mm011106/509_circuit/parts/obsolate/ER150D_24ch_parts_Main.MBOM.txt

---	2	 C14 R62
1SS372	2	 D1 D2
AD8227ARZ	1	 U11
0.1u/16V	30	 C9 C10 C11 C15 C16 C18 C21 C22 C24 C25 C27 C28 C30 C32 C34 C36 C38 C39 C41 C42 C43 C44 C45 C47 C48 C49 C50 C51 C54 C55
7.5k	1	 R5
TLP291GR	1	 U30
20k/POT	1	 R12
74VHC9541FT	1	 U29
15k/0.05%/10ppm	1	 R57
TPS79918DDC	1	 U28
MAX4617CUE+	8	 U12 U14 U16 U18 U20 U22 U23 U25
10k/THICK	2	 R63 R66
2.2n	1	 C19
PCS-XE50LFD	1	 CN16
39k	1	 R50
DF11-14DP-2DSA	1	 CN20
30/THICK	1	 R46
20k/THICK	5	 R78 R79 R80 R81 R82
1SS226	1	 D3
NJU7108F3	1	 U7
91k	1	 R6
22n	3	 C1 C2 C6
68k	3	 R7 R42 R43
47k	1	 R4
VAB-3-10	1	 M1
PIN_HEADER_SOCKET_14PIN	1	 CN19
TPS3808G01DBV	1	 U6
0	5	 R22 R27 R28 R33 R35
51k	18	 R8 R9 R10 R11 R13 R14 R15 R16 R21 R30 R31 R32 R37 R38 R40 R41 R44 R45
4.7u/25V	2	 C13 C53
1k/THICK	7	 R65 R67 R68 R69 R70 R71 R83
56u/10V/OS	3	 C8 C23 C46
74VHC4052AFT	1	 U10
2k/THICK	1	 R84
11k	1	 R25
47/THICK	2	 R18 R39
ACM4520-142	5	 L1 L2 L3 L4 L5
TS5A23159DGS	2	 U3 U9
1M/THICK	1	 R34
3.3n	4	 C3 C4 C5 C7
82k	1	 R3
4.7n	1	 C17
DF11-4DP-2DSA	4	 CN1 CN2 CN3 CN4
RXEF050	1	 F1
10u/25V	1	 C57
100/0.05%/10ppm	1	 R56
OPA2344EA	4	 U1 U2 U5 U8
5M160ZT100	1	 U27
TP-1MMPAD	4	 TP11 TP12 TP13 TP14
100k	5	 R1 R47 R48 R51 R52
9.1k	2	 R17 R23
PH-2X5S	1	 CN18
620/THICK	1	 R58
TP-LC3G	10	 TP1 TP2 TP3 TP4 TP5 TP6 TP7 TP8 TP9 TP15
110k	1	 R24
1u/25V	7	 C20 C26 C58 C59 C60 C61 C62
2k/0.05%/10ppm	1	 R55
5.6k	1	 R49
100k/POT	1	 R2
TPS79933DDC	2	 U4 U26
100k/THICK	9	 R26 R36 R64 R72 R73 R74 R75 R76 R77
10k	5	 R19 R20 R29 R53 R54
10n	3	 C12 C52 C56
