mm011106/509_circuit/parts/obsolate/ER150D_24ch_parts_main_PBAN.xlsx

Sheet: 必ずお読みください
入力項目説明
メ ー カ ー |  |  | 電子部品のメーカー名をご入力ください。
部 品 種 別 |  |  | 電子部品の種別をご入力ください。例：チップ抵抗、トランジスタ、LED、など
電 子 部 品 型 番 |  |  | 電子部品の型番をご入力ください。 ※誤表記による不具合を回避するためにも正確なご入力をお願い致します。 ※表面実装の抵抗やコンデンサ(電解、タンタル以外)は、後述「電子部品見取り表」をご参照のうえ、ご入力ください。
配 置 記 号 / リファレンス |  |  | シルク図/配置図に表記された配置記号/リファレンス番号をご入力ください。 ※複数入力する場合は、カンマ「,」区切りでのご入力をお願い致します。 (入力例)R1～R5、R1-5と略さず、R1,R2,R3,R4,R5とご入力ください。 ※電子部品型番ベースでのご記入をお願い致します。（１つの電子部品型番に対して、配置番号を複数記入）
個 数 |  |  | 電子部品の個数をご入力ください。
ピ ン 数 |  |  | 電子部品の総ピン数をご入力ください。 ※基板取付穴、部品取付穴、全てのスルー・ノンスルーホール、面実装部品のパッド、及び次の①～⑤の配線を伴う箇所（①テストピン、②チェックランド、③引き出しランド、④ジャンパピン、⑤入出力ランドの総計。
実装 / 未実装 |  |  | 実装サービスでの「実装」/「未実装」をご選択ください。 ※同じ電子部品型番の中で実装と未実装が分かれる場合は、それぞれ2行に分けて配置記号をご入力ください。
部品分類 | SMD |  | 表面実装部品
 | DIP |  | 挿入部品
 | 特殊 BGA等 |  | BGA/CSP/LGA/QFNなど部品極性が部品の真下に配置された部品 -BGA：Ball Grid Array/下面に半田ボールの端子を配置したパッケージ。 -CSP：Chip Size Package/チッププサイズと同じか、もしくは僅かに大きいパッケージ。 -LGA：Land Grid Array/裏面に外部入出力用のランドを設けたパッケージ。※BGAの半田ボールがない。 -QFN：Quad Flat Non-Lead Package/QFPに似ていますが、外部入出力用のピンが出ていないパッケージ。
P板.com提供部品 (無料) |  |  | 【無償提供部品一覧】シートに記載されている「メーカー型番」を【部品リスト入力フォーム】シートのD列（電子部品型番）に入力し、I列（実装／未実装）を「実装」に設定いただくと、自動的に「○」が表示されます。 ※無料提供部品：チップコンデンサ/チップ抵抗を約1000種、実装サービスをご利用のお客様に無料提供いたします。 ※「○」が付かない場合は全半角の不一致などにより誤判定されている可能性があります。【無償提供部品一覧】シートより型番をコピー＆ペーストにて【部品リスト入力フォーム】にご入力ください。
 |  |  | http://www.p-ban.com/implementation/chip.html
P板.com調達部品(有料） |  |  | P板.com実装サービスで部品調達を希望される場合に○をご選択ください。 ※調達費用のお見積もりは、部品リストの返却と同時にご連絡いたします。 ※ご希望の納期や市場在庫状況によっては、調達が不可となる部品もございますので、予めご了承ください。
パッケージ情報 部品外形/部品仕様 |  |  | 電子部品のパッケージ情報をご入力ください。例：1608 , DIP , 0.5mmピッチQFP , 0.4mmピッチCN
コ メ ン ト |  |  | 特別なご指示のある電子部品について、自由にご入力ください。 例：未実装挿入穴のマスク処理が必要、など
版、変更履歴 |  |  | 部品種毎に、変更履歴を記載してください。 版は、アカウント登録の版に合わせて記載ください。
調達型式、代替型式 |  |  | 無料提供部品の在庫切れや、正確な調達型式を記載いたします。
部品名称見取り表
1.チップ部品（抵抗、コンデンサ）
 |  |  |  |  | 単位：ｍｍ
 |  |  | 電子部品型番 (C:コンデンサ、R:抵抗） | Ａ寸法 | Ｂ寸法
 |  |  | C/R1608 | 1.6 | 0.8
 |  |  | C/R2125 | 2 | 1.25
 |  |  | C/R3216 | 3.2 | 1.6
 |  |  | C/R3225 | 3.2 | 2.5
 |  |  | C/R4532 | 4.5 | 3.2
2.チップタンタルコンデンサ
 |  |  |  |  | 単位：ｍｍ
 |  |  | 電子部品型番 | Ａ寸法 | Ｂ寸法
 |  |  | CT3216 | 3.2 | 1.6
 |  |  | CT3528 | 3.5 | 2.8
 |  |  | CT4726 | 4.7 | 2.6
 |  |  | CT6032 | 6 | 3.2
 |  |  | CT5846 | 5.8 | 4.6
 |  |  | CT7343 | 7.3 | 4.3
3.チップアルミ電解コンデンサ
 |  |  |  |  |  | 単位：ｍｍ
 |  |  | 電子部品型番 | Ａ寸法 | Ｂ寸法 | C寸法
 |  |  | CE33 | 3.3 | 3.3 | φ3.0
 |  |  | CE43 | 4.3 | 4.3 | φ4.0
 |  |  | CE53 | 5.3 | 5.3 | φ5.0
 |  |  | CE66 | 6.6 | 6.6 | φ6.3
 |  |  | CE83 | 8.3 | 8.3 | φ8.0
 |  |  | CE103 | 10.3 | 10.3 | φ10.0
部品取り付け穴は、ピン数に含めてください。
コネクタの場合 |  |  |  |  |  | トランスの場合
部品リストフォーマット変更履歴
2014-02-01 | v2.0 | 松森 | 部品種別の総計を、直接関数に変更
 |  |  | ピン数合計、実装数合計数量を、直接関数に変更
 |  |  | 部品調達見積欄を修正
2014-03-11 | v2.1 | 松森 | *N列、O列が下の方、"○"選択リスト消えていたのを追加
 |  |  | *縮小しても解像度崩れず文字表示するため、フォントを"Meiryo UI"(Windows 標準添付)に変更
 |  |  | *136行目以降を非表示
 |  |  | *"X"列にリストを埋め込み
2014-06-12 | v2.2 | 松森 | *固定行を変更
 |  |  | *在庫状況列に条件付き書式設定
 |  |  | *その他各種バグ修正
2015-03-31 | V2.3 | 松森 | *無償提供部品を記載すると、無償提供部品欄に自動で"○"が表示されるよう条件式を挿入
 |  |  | *併せて、無償提供部品参照用一覧シートの作成・追加
 |  |  | *最小購入数が必要数量を下回る場合、セルを赤色にハッチングする
 |  |  | *シート1の名称変更
 |  |  | *変更履歴シートの追加
2015-06-19 | v2.4 | 松森 | ・ゼロΩ抵抗を無償対象に追加
 |  |  | ・変更履歴の列を追加し、変更履歴シートを削除
 |  |  | ・その他書式、印刷機能の変更
 |  |  | ・無償提供部品の入れ替え
2015-08-14 | v2.5 | 松森 | ・ゼロΩ抵抗の無償対象品が正しく反映されていなかったバグ修正
 |  |  | ・フォームへバージョン情報を埋め込み
2015-11-05 | v2.6 | 上田 | ・無償提供部品(RK73H2ATTD1601F)の抵抗値を正しい値に修正
2015-11-09 | v2.7 | 上田 | ・P板.com調達部品(無料)欄のフォントを変更
2016-01-15 | v2.8 | 箕浦 | ・無償提供部品一覧の「GRM32NF11E106Z」を削除
 |  |  | ・部品リスト入力フォームの4行目F列～L列の計算式が136行目以降を対象としていなかった不具合を修正
2016-01-27 | v2.9 | 箕浦 | ・「無償提供部品一覧」シートの表記修正
2016-08-26 | v2.10 | 松森 | ・「GRM31CF11E106Z」の許容差値修正
2016-11-15 | v2.11 | 松森 | ・部品調達欄表示順序変更
 |  |  | ・備考欄、荷姿欄追加
 |  |  | ・在庫状況のリスト微修正
2017-03-21 | v2.12 | 松森 | ・調達金額合計欄作成
 |  |  | ・在庫状況「長納期」を追加
 |  |  | ・その他微修正
2017-06-29 | v2.13 | 松森 | ・村田製3216サイズ以上のチップコンの取扱い中止
2017-07-19 | V2.14 | 松森 | ・KOA製1005サイズの定格電力を0.1Wに変更
 |  |  | (2015年10月のKOA仕様変更に伴う)
2017-09-14 | v2.15 | 松森 | ・KOA製2012サイズの定格電力を0.25Wへ変更
 |  |  | ・KOA製1608サイズ、1K以下の定格電力を0.125Wへ変更
 |  |  | ・MURATA製一部型式、許容差および定格修正
 |  |  | ・MURATA製一部部品削除
 |  |  | ・その他書式設定等微修正
2017-10-12 | v2.20 | 松森 | ・部品調達関連項目の移動
 |  |  | ・条件付き書式追加
2018-06-22 | v2.31 | 松森 | ・「1608」サイズと「2012」サイズのチップコンデンサを無償対象品から除外
2018-10-18 | V2.32 | 山田 | ・部品調達関連項目追加（条件付き書式追加/在庫状況：在庫少追加）
 |  |  | ・「必ずお読みください」シートの「配置記号 / リファレンス」の項目修正（配置記号の省略について）
2019-09-05 | V2.4 | 岡田 | Excelファイル名を部品表内に表記する関数追加
 |  |  | 無償提供部品型番入力後にスペースが入るとO列に丸がされない問題を修正
2019-09-10 | V2.41 | 岡田 | "AD"列にトレイ追加

Sheet: 部品リスト入力フォーム
partslist(Rev,2.41) |  |  | 電 子 部 品 型 番 ※半角英数字 ※サフィックスまで入力必須 | 配 置 記 号 リ フ ァ レ ン ス ※半角英数字） | 個数 | ピ ン 数 (部品取付穴 を含む） |  | 実装/ 未実装 | 部 品 分 類 |  |  | 必要数 実装枚数を入れてください。 ↓ | P板.com 提供 部品 (無料) | P板.com 調達 部品 (有料） | パッケージ情報 部品外形/部品仕様 | コ メ ン ト ※未実装挿入穴のマスク 処理が必要、など | 版 変更履歴 | 入荷数 | 返却
ER150D_24ch_parts_main_PBAN.xlsx
No | メーカー | 部品種別 |  |  |  | 1個 あたり | 合計 | 実装個数 | SMD | DIP | 特殊 BGA等 |  |  |  |  |  |  |  |  | P板.com部品調達使用欄
 |  |  |  |  | 187 | 389 | 774 | 186 | 162 | 24 | 0 | 2 | リスト (http://www.p-ban.com/implementation/chip.html)
例 | KOA | チップ抵抗 | RK73B2ATTD1002F | R1,R5,R9,R10 | 4 | 2 | 8 | 未実装 | SMD |  |  |  |  |  | 2012 |  | 4版 型式訂正、個数変更、 実装→未実装へ |  |  | 必要数 | 調達数 | 在庫状況 | メーカ | 調達品番 | 荷姿 | 納期 | 備考
1 □ | AD | 差動アンプ | AD8227ARZ | U11 | 1 | 8 | 8 | 実装 | SMD |  |  | 2 |  |  |  |  |  |  | □
2 □ | AKIZUKI | 2列ピンソケット | C-00169 | CN19 | 1 | 14 | 14 | 実装 | DIP |  |  | 2 |  |  |  |  |  |  | □
3 □ | AKIZUKI | 2列ピンヘッダ | PH-2x5SG | CN18 | 1 | 10 | 10 | 実装 | DIP |  |  | 2 |  |  |  |  |  |  | □
4 □ | ALTERA | CPLD | 5M160ZT100C5N | U27 | 1 | 100 | 100 | 実装 | SMD |  |  | 2 |  |  |  |  |  |  | □
5 □ | COPAL | 単回転ポテンショ | CT-6EP100kohm | R2 | 1 | 3 | 3 | 実装 | DIP |  |  | 2 |  |  |  |  |  |  | □
6 □ | COPAL | 単回転ポテンショ | CT-6EP20kohm | R12 | 1 | 3 | 3 | 実装 | DIP |  |  | 2 |  |  |  |  |  |  | □
7 □ | HIROSE | DF11コネクタ(PLUG) | DF11-14DP-2DSA(24) | CN20 | 1 | 14 | 14 | 実装 | DIP |  |  | 2 |  |  |  |  |  |  | □
8 □ | HIROSE | DF11コネクタ(PLUG) | DF11-4DP-2DSA(24) | CN1,CN2,CN3,CN4 | 4 | 4 | 16 | 実装 | DIP |  |  | 8 |  |  |  |  |  |  | □
9 □ | HIROSUGI | 取り付けスペーサ | VAB-3-10 | M1 | 1 | 1 | 1 | 未実装 | DIP |  |  | 0 |  |  |  |  |  |  | □
10 □ | HONDA | ハーフピッチSCSIコネクタ | PCS-XE50LFD+ | CN16 | 1 | 52 | 52 | 実装 | DIP |  |  | 2 |  |  |  |  |  |  | □
11 □ | JRC | コンパレータ | NJU7108F3 | U7 | 1 | 5 | 5 | 実装 | SMD |  |  | 2 |  |  |  |  |  |  | □
12 □ | KOA | 厚膜チップ抵抗 | RK73H1JTTD1001F | R65,R67,R68,R69,R70,R71,R83 | 7 | 2 | 14 | 実装 | SMD |  |  | 14 | ○ |  |  |  |  |  | □
13 □ | KOA | 厚膜チップ抵抗 | RK73H1JTTD1002F | R63,R66 | 2 | 2 | 4 | 実装 | SMD |  |  | 4 | ○ |  |  |  |  |  | □
14 □ | KOA | 厚膜チップ抵抗 | RK73H1JTTD1003F | R26,R36,R64,R72,R73,R74,R75,R76,R77 | 9 | 2 | 18 | 実装 | SMD |  |  | 18 | ○ |  |  |  |  |  | □
15 □ | KOA | 厚膜チップ抵抗 | RK73H1JTTD1004F | R34 | 1 | 2 | 2 | 実装 | SMD |  |  | 2 | ○ |  |  |  |  |  | □
16 □ | KOA | 厚膜チップ抵抗 | RK73H1JTTD2001F | R84 | 1 | 2 | 2 | 実装 | SMD |  |  | 2 | ○ |  |  |  |  |  | □
17 □ | KOA | 厚膜チップ抵抗 | RK73H1JTTD2002F | R78,R79,R80,R81,R82 | 5 | 2 | 10 | 実装 | SMD |  |  | 10 | ○ |  |  |  |  |  | □
18 □ | KOA | 厚膜チップ抵抗 | RK73H1JTTD30R0F | R46 | 1 | 2 | 2 | 実装 | SMD |  |  | 2 | ○ |  |  |  |  |  | □
19 □ | KOA | 厚膜チップ抵抗 | RK73H1JTTD47R0F | R18,R39 | 2 | 2 | 4 | 実装 | SMD |  |  | 4 | ○ |  |  |  |  |  | □
20 □ | KOA | 厚膜チップ抵抗 | RK73H1JTTD6200F | R58 | 1 | 2 | 2 | 実装 | SMD |  |  | 2 | ○ |  |  |  |  |  | □
21 □ | KOA | 厚膜チップ抵抗 | RK73Z1JTTD | R22,R27,R28,R33,R35 | 5 | 2 | 10 | 実装 | SMD |  |  | 10 | ○ |  |  |  |  |  | □
22 □ | MAC8 | テストポイント | LC-33-G | TP1,TP2,TP3,TP4,TP5,TP6,TP7,TP8,TP9,TP15 | 10 | 1 | 10 | 実装 | DIP |  |  | 20 |  |  |  |  |  |  | □
23 □ | MAXIM | アナログMPX | MAX4617CUE+ | U12,U14,U16,U18,U20,U22,U23,U25 | 8 | 16 | 128 | 実装 | SMD |  |  | 16 |  |  |  |  |  |  | □
24 □ | Panasonic | アルミ固体コンデンサ | 10SEP56M | C8,C23,C46 | 3 | 2 | 6 | 実装 | DIP |  |  | 6 |  |  |  |  |  |  | □
25 □ | SSM | 薄膜チップ抵抗 | RG1608N-101-W | R56 | 1 | 2 | 2 | 実装 | SMD |  |  | 2 |  |  |  |  |  |  | □
26 □ | SSM | 薄膜チップ抵抗 | RG1608N-153-W | R57 | 1 | 2 | 2 | 実装 | SMD |  |  | 2 |  |  |  |  |  |  | □
27 □ | SSM | 薄膜チップ抵抗 | RG1608N-202-W | R55 | 1 | 2 | 2 | 実装 | SMD |  |  | 2 |  |  |  |  |  |  | □
28 □ | SSM | 薄膜チップ抵抗 | RR0816P-103-D | R19,R20,R29,R53,R54 | 5 | 2 | 10 | 実装 | SMD |  |  | 10 |  |  |  |  |  |  | □
29 □ | SSM | 薄膜チップ抵抗 | RR0816P-104-D | R1,R47,R48,R51,R52 | 5 | 2 | 10 | 実装 | SMD |  |  | 10 |  |  |  |  |  |  | □
30 □ | SSM | 薄膜チップ抵抗 | RR0816P-113-D | R25 | 1 | 2 | 2 | 実装 | SMD |  |  | 2 |  |  |  |  |  |  | □
31 □ | SSM | 薄膜チップ抵抗 | RR0816P-114-D | R24 | 1 | 2 | 2 | 実装 | SMD |  |  | 2 |  |  |  |  |  |  | □
32 □ | SSM | 薄膜チップ抵抗 | RR0816P-393-D | R50 | 1 | 2 | 2 | 実装 | SMD |  |  | 2 |  |  |  |  |  |  | □
33 □ | SSM | 薄膜チップ抵抗 | RR0816P-473-D | R4 | 1 | 2 | 2 | 実装 | SMD |  |  | 2 |  |  |  |  |  |  | □
34 □ | SSM | 薄膜チップ抵抗 | RR0816P-513-D | R8,R9,R10,R11,R13,R14,R15,R16,R21,R30,R31,R32,R37,R38,R40,R41,R44,R45 | 18 | 2 | 36 | 実装 | SMD |  |  | 36 |  |  |  |  |  |  | □
35 □ | SSM | 薄膜チップ抵抗 | RR0816P-562-D | R49 | 1 | 2 | 2 | 実装 | SMD |  |  | 2 |  |  |  |  |  |  | □
36 □ | SSM | 薄膜チップ抵抗 | RR0816P-683-D | R7,R42,R43 | 3 | 2 | 6 | 実装 | SMD |  |  | 6 |  |  |  |  |  |  | □
37 □ | SSM | 薄膜チップ抵抗 | RR0816P-752-D | R5 | 1 | 2 | 2 | 実装 | SMD |  |  | 2 |  |  |  |  |  |  | □
38 □ | SSM | 薄膜チップ抵抗 | RR0816P-823-D | R3 | 1 | 2 | 2 | 実装 | SMD |  |  | 2 |  |  |  |  |  |  | □
39 □ | SSM | 薄膜チップ抵抗 | RR0816P-912-D | R17,R23 | 2 | 2 | 4 | 実装 | SMD |  |  | 4 |  |  |  |  |  |  | □
40 □ | SSM | 薄膜チップ抵抗 | RR0816P-913-D | R6 | 1 | 2 | 2 | 実装 | SMD |  |  | 2 |  |  |  |  |  |  | □
41 □ | TDK | コモンモードチョーク | ACM4520-142-2P | L1,L2,L3,L4,L5 | 5 | 4 | 20 | 実装 | SMD |  |  | 10 |  |  |  |  |  |  | □
42 □ | TDK | 積層セラミックコンデンサ | C1608X5R1E475K | C13,C53 | 2 | 2 | 4 | 実装 | SMD |  |  | 4 |  |  |  |  |  |  | □
43 □ | TDK | 積層セラミックコンデンサ | CGA3E3X5R1E105K | C20,C26,C58,C59,C60,C61,C62 | 7 | 2 | 14 | 実装 | SMD |  |  | 14 |  |  |  |  |  |  | □
44 □ | TE | ポリスイッチ | RXEF050 | F1 | 1 | 2 | 2 | 実装 | DIP |  |  | 2 |  |  |  |  |  |  | □
45 □ | TI | アナログスイッチ | TS5A23159DGS | U3,U9 | 2 | 10 | 20 | 実装 | SMD |  |  | 4 |  |  |  |  |  |  | □
46 □ | TI | オペアンプ | OPA2344EA | U1,U2,U5,U8 | 4 | 8 | 32 | 実装 | SMD |  |  | 8 |  |  |  |  |  |  | □
47 □ | TI | 電圧レギュレータ | TPS79918DDC | U28 | 1 | 5 | 5 | 実装 | SMD |  |  | 2 |  |  |  |  |  |  | □
48 □ | TI | 電圧レギュレータ | TPS79933DDC | U4,U26 | 2 | 5 | 10 | 実装 | SMD |  |  | 4 |  |  |  |  |  |  | □
49 □ | TI | 電圧監視 | TPS3808G01DBV | U6 | 1 | 6 | 6 | 実装 | SMD |  |  | 2 |  |  |  |  |  |  | □
50 □ | TOSHIBA | C-MOS | 74VHC9541FT | U29 | 1 | 20 | 20 | 実装 | SMD |  |  | 2 |  |  |  |  |  |  | □
51 □ | TOSHIBA | C-MOS | TC74VHC4052AFT | U10 | 1 | 16 | 16 | 実装 | SMD |  |  | 2 |  |  |  |  |  |  | □
52 □ | TOSHIBA | ショットキーダイオード | 1SS226 | D3 | 1 | 3 | 3 | 実装 | SMD |  |  | 2 |  |  |  |  |  |  | □
53 □ | TOSHIBA | ショットキーダイオード | 1SS372 | D1,D2 | 2 | 3 | 6 | 実装 | SMD |  |  | 4 |  |  |  |  |  |  | □
54 □ | TOSHIBA | フォトカプラ | TLP291(GR,SE | U30 | 1 | 4 | 4 | 実装 | SMD |  |  | 2 |  |  |  |  |  |  | □
55 □ | 村田製作所 | 積層セラミックコンデンサ | GRM155B31C104K | C9,C10,C11,C15,C16,C18,C21,C22,C24,C25,C27,C28,C30,C32,C34,C36,C38,C39,C41,C42,C43,C44,C45,C47,C48,C49,C50,C51,C54,C55 | 30 | 2 | 60 | 実装 | SMD |  |  | 60 | ○ |  |  |  |  |  | □
56 □ | 村田製作所 | 積層セラミックコンデンサ | GRM2195C1H103J | C12,C52,C56 | 3 | 2 | 6 | 実装 | SMD |  |  | 6 |  |  |  |  |  |  | □
57 □ | 村田製作所 | 積層セラミックコンデンサ | GRM1882C1H222J | C19 | 1 | 2 | 2 | 実装 | SMD |  |  | 2 |  |  |  |  |  |  | □
58 □ | 村田製作所 | 積層セラミックコンデンサ | GRM1882C1H332J | C3,C4,C5,C7 | 4 | 2 | 8 | 実装 | SMD |  |  | 8 |  |  |  |  |  |  | □
59 □ | 村田製作所 | 積層セラミックコンデンサ | GRM2162C1H472J | C17 | 1 | 2 | 2 | 実装 | SMD |  |  | 2 |  |  |  |  |  |  | □
60 □ | 村田製作所 | 積層セラミックコンデンサ | GRM21B2C1H223J | C1,C2,C6 | 3 | 2 | 6 | 実装 | SMD |  |  | 6 |  |  |  |  |  |  | □
61 □ | 村田製作所 | 積層セラミックコンデンサ | GRM31CR61E106K | C57 | 1 | 2 | 2 | 実装 | SMD |  |  | 2 |  |  |  |  |  |  | □
62 □ |  |  |  |  |  |  |  |  |  |  |  |  |  |  |  |  |  |  | □
63 □ |  |  |  |  |  |  |  |  |  |  |  |  |  |  |  |  |  |  | □
64 □ |  |  |  |  |  |  |  |  |  |  |  |  |  |  |  |  |  |  | □
65 □ |  |  |  |  |  |  |  |  |  |  |  |  |  |  |  |  |  |  | □
66 □ |  |  |  |  |  |  |  |  |  |  |  |  |  |  |  |  |  |  | □
67 □ |  |  |  |  |  |  |  |  |  |  |  |  |  |  |  |  |  |  | □
68 □ |  |  |  |  |  |  |  |  |  |  |  |  |  |  |  |  |  |  | □
69 □ |  |  |  |  |  |  |  |  |  |  |  |  |  |  |  |  |  |  | □
70 □ |  |  |  |  |  |  |  |  |  |  |  |  |  |  |  |  |  |  | □
71 □ |  |  |  |  |  |  |  |  |  |  |  |  |  |  |  |  |  |  | □
72 □ |  |  |  |  |  |  |  |  |  |  |  |  |  |  |  |  |  |  | □
73 □ |  |  |  |  |  |  |  |  |  |  |  |  |  |  |  |  |  |  | □
74 □ |  |  |  |  |  |  |  |  |  |  |  |  |  |  |  |  |  |  | □
75 □ |  |  |  |  |  |  |  |  |  |  |  |  |  |  |  |  |  |  | □
76 □ |  |  |  |  |  |  |  |  |  |  |  |  |  |  |  |  |  |  | □
77 □ |  |  |  |  |  |  |  |  |  |  |  |  |  |  |  |  |  |  | □
78 □ |  |  |  |  |  |  |  |  |  |  |  |  |  |  |  |  |  |  | □
79 □ |  |  |  |  |  |  |  |  |  |  |  |  |  |  |  |  |  |  | □
80 □ |  |  |  |  |  |  |  |  |  |  |  |  |  |  |  |  |  |  | □
81 □ |  |  |  |  |  |  |  |  |  |  |  |  |  |  |  |  |  |  | □
82 □ |  |  |  |  |  |  |  |  |  |  |  |  |  |  |  |  |  |  | □
83 □ |  |  |  |  |  |  |  |  |  |  |  |  |  |  |  |  |  |  | □
84 □ |  |  |  |  |  |  |  |  |  |  |  |  |  |  |  |  |  |  | □
85 □ |  |  |  |  |  |  |  |  |  |  |  |  |  |  |  |  |  |  | □
86 □ |  |  |  |  |  |  |  |  |  |  |  |  |  |  |  |  |  |  | □
87 □ |  |  |  |  |  |  |  |  |  |  |  |  |  |  |  |  |  |  | □
88 □ |  |  |  |  |  |  |  |  |  |  |  |  |  |  |  |  |  |  | □
89 □ |  |  |  |  |  |  |  |  |  |  |  |  |  |  |  |  |  |  | □
90 □ |  |  |  |  |  |  |  |  |  |  |  |  |  |  |  |  |  |  | □
91 □ |  |  |  |  |  |  |  |  |  |  |  |  |  |  |  |  |  |  | □
92 □ |  |  |  |  |  |  |  |  |  |  |  |  |  |  |  |  |  |  | □
93 □ |  |  |  |  |  |  |  |  |  |  |  |  |  |  |  |  |  |  | □
94 □ |  |  |  |  |  |  |  |  |  |  |  |  |  |  |  |  |  |  | □
95 □ |  |  |  |  |  |  |  |  |  |  |  |  |  |  |  |  |  |  | □
96 □ |  |  |  |  |  |  |  |  |  |  |  |  |  |  |  |  |  |  | □
97 □ |  |  |  |  |  |  |  |  |  |  |  |  |  |  |  |  |  |  | □
98 □ |  |  |  |  |  |  |  |  |  |  |  |  |  |  |  |  |  |  | □
99 □ |  |  |  |  |  |  |  |  |  |  |  |  |  |  |  |  |  |  | □
100 □ |  |  |  |  |  |  |  |  |  |  |  |  |  |  |  |  |  |  | □
101 □ |  |  |  |  |  |  |  |  |  |  |  |  |  |  |  |  |  |  | □
102 □ |  |  |  |  |  |  |  |  |  |  |  |  |  |  |  |  |  |  | □
103 □ |  |  |  |  |  |  |  |  |  |  |  |  |  |  |  |  |  |  | □
104 □ |  |  |  |  |  |  |  |  |  |  |  |  |  |  |  |  |  |  | □
105 □ |  |  |  |  |  |  |  |  |  |  |  |  |  |  |  |  |  |  | □
106 □ |  |  |  |  |  |  |  |  |  |  |  |  |  |  |  |  |  |  | □
107 □ |  |  |  |  |  |  |  |  |  |  |  |  |  |  |  |  |  |  | □
108 □ |  |  |  |  |  |  |  |  |  |  |  |  |  |  |  |  |  |  | □
109 □ |  |  |  |  |  |  |  |  |  |  |  |  |  |  |  |  |  |  | □
110 □ |  |  |  |  |  |  |  |  |  |  |  |  |  |  |  |  |  |  | □
111 □ |  |  |  |  |  |  |  |  |  |  |  |  |  |  |  |  |  |  | □
112 □ |  |  |  |  |  |  |  |  |  |  |  |  |  |  |  |  |  |  | □
113 □ |  |  |  |  |  |  |  |  |  |  |  |  |  |  |  |  |  |  | □
114 □ |  |  |  |  |  |  |  |  |  |  |  |  |  |  |  |  |  |  | □
115 □ |  |  |  |  |  |  |  |  |  |  |  |  |  |  |  |  |  |  | □
116 □ |  |  |  |  |  |  |  |  |  |  |  |  |  |  |  |  |  |  | □
117 □ |  |  |  |  |  |  |  |  |  |  |  |  |  |  |  |  |  |  | □
118 □ |  |  |  |  |  |  |  |  |  |  |  |  |  |  |  |  |  |  | □
119 □ |  |  |  |  |  |  |  |  |  |  |  |  |  |  |  |  |  |  | □
120 □ |  |  |  |  |  |  |  |  |  |  |  |  |  |  |  |  |  |  | □
121 □ |  |  |  |  |  |  |  |  |  |  |  |  |  |  |  |  |  |  | □
122 □ |  |  |  |  |  |  |  |  |  |  |  |  |  |  |  |  |  |  | □
123 □ |  |  |  |  |  |  |  |  |  |  |  |  |  |  |  |  |  |  | □
124 □ |  |  |  |  |  |  |  |  |  |  |  |  |  |  |  |  |  |  | □
125 □ |  |  |  |  |  |  |  |  |  |  |  |  |  |  |  |  |  |  | □
126 □ |  |  |  |  |  |  |  |  |  |  |  |  |  |  |  |  |  |  | □
127 □ |  |  |  |  |  |  |  |  |  |  |  |  |  |  |  |  |  |  | □
128 □ |  |  |  |  |  |  |  |  |  |  |  |  |  |  |  |  |  |  | □
129 □ |  |  |  |  |  |  |  |  |  |  |  |  |  |  |  |  |  |  | □
130 □ |  |  |  |  |  |  |  |  |  |  |  |  |  |  |  |  |  |  | □
131 □ |  |  |  |  |  |  |  |  |  |  |  |  |  |  |  |  |  |  | □
132 □ |  |  |  |  |  |  |  |  |  |  |  |  |  |  |  |  |  |  | □
133 □ |  |  |  |  |  |  |  |  |  |  |  |  |  |  |  |  |  |  | □
134 □ |  |  |  |  |  |  |  |  |  |  |  |  |  |  |  |  |  |  | □
135 □ |  |  |  |  |  |  |  |  |  |  |  |  |  |  |  |  |  |  | □
136 □ |  |  |  |  |  |  |  |  |  |  |  |  |  |  |  |  |  |  | □
137 □ |  |  |  |  |  |  |  |  |  |  |  |  |  |  |  |  |  |  | □
138 □ |  |  |  |  |  |  |  |  |  |  |  |  |  |  |  |  |  |  | □
139 □ |  |  |  |  |  |  |  |  |  |  |  |  |  |  |  |  |  |  | □
140 □ |  |  |  |  |  |  |  |  |  |  |  |  |  |  |  |  |  |  | □
141 □ |  |  |  |  |  |  |  |  |  |  |  |  |  |  |  |  |  |  | □
142 □ |  |  |  |  |  |  |  |  |  |  |  |  |  |  |  |  |  |  | □
143 □ |  |  |  |  |  |  |  |  |  |  |  |  |  |  |  |  |  |  | □
144 □ |  |  |  |  |  |  |  |  |  |  |  |  |  |  |  |  |  |  | □
145 □ |  |  |  |  |  |  |  |  |  |  |  |  |  |  |  |  |  |  | □
146 □ |  |  |  |  |  |  |  |  |  |  |  |  |  |  |  |  |  |  | □
147 □ |  |  |  |  |  |  |  |  |  |  |  |  |  |  |  |  |  |  | □
148 □ |  |  |  |  |  |  |  |  |  |  |  |  |  |  |  |  |  |  | □

Sheet: 無償提供部品一覧
このシートの内容は変更しないでください。
メーカー型番 |  | メーカー | サイズ | 定数 | 許容差 | 定格
RK73Z1ETTP | ○ | KOA | 1005 | 0 | － | 1A
RK73H1ETTP1R00F | ○ | KOA | 1005 | 1 | ±1% | 0.1W
RK73B1ETTP1R0J | ○ | KOA | 1005 | 1 | ±5% | 0.1W
RK73H1ETTP1R10F | ○ | KOA | 1005 | 1.1 | ±1% | 0.1W
RK73B1ETTP1R1J | ○ | KOA | 1005 | 1.1 | ±5% | 0.1W
RK73H1ETTP1R20F | ○ | KOA | 1005 | 1.2 | ±1% | 0.1W
RK73B1ETTP1R2J | ○ | KOA | 1005 | 1.2 | ±5% | 0.1W
RK73H1ETTP1R30F | ○ | KOA | 1005 | 1.3 | ±1% | 0.1W
RK73B1ETTP1R3J | ○ | KOA | 1005 | 1.3 | ±5% | 0.1W
RK73H1ETTP1R50F | ○ | KOA | 1005 | 1.5 | ±1% | 0.1W
RK73B1ETTP1R5J | ○ | KOA | 1005 | 1.5 | ±5% | 0.1W
RK73H1ETTP1R60F | ○ | KOA | 1005 | 1.6 | ±1% | 0.1W
RK73B1ETTP1R6J | ○ | KOA | 1005 | 1.6 | ±5% | 0.1W
RK73H1ETTP1R80F | ○ | KOA | 1005 | 1.8 | ±1% | 0.1W
RK73B1ETTP1R8J | ○ | KOA | 1005 | 1.8 | ±5% | 0.1W
RK73H1ETTP2R00F | ○ | KOA | 1005 | 2 | ±1% | 0.1W
RK73B1ETTP2R0J | ○ | KOA | 1005 | 2 | ±5% | 0.1W
RK73H1ETTP2R20F | ○ | KOA | 1005 | 2.2 | ±1% | 0.1W
RK73B1ETTP2R2J | ○ | KOA | 1005 | 2.2 | ±5% | 0.1W
RK73H1ETTP2R40F | ○ | KOA | 1005 | 2.4 | ±1% | 0.1W
RK73B1ETTP2R4J | ○ | KOA | 1005 | 2.4 | ±5% | 0.1W
RK73H1ETTP2R70F | ○ | KOA | 1005 | 2.7 | ±1% | 0.1W
RK73B1ETTP2R7J | ○ | KOA | 1005 | 2.7 | ±5% | 0.1W
RK73H1ETTP3R00F | ○ | KOA | 1005 | 3 | ±1% | 0.1W
RK73B1ETTP3R0J | ○ | KOA | 1005 | 3 | ±5% | 0.1W
RK73H1ETTP3R30F | ○ | KOA | 1005 | 3.3 | ±1% | 0.1W
RK73B1ETTP3R3J | ○ | KOA | 1005 | 3.3 | ±5% | 0.1W
RK73H1ETTP3R60F | ○ | KOA | 1005 | 3.6 | ±1% | 0.1W
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
GRM155B11H272K | ○ | MURATA | 1005 | 2700pF | ±10% | DC50V
GRM155B11H332K | ○ | MURATA | 1005 | 3300pF | ±10% | DC50V
GRM155B11H392K | ○ | MURATA | 1005 | 3900pF | ±10% | DC50V
GRM155B11H472K | ○ | MURATA | 1005 | 4700pF | ±10% | DC50V
GRM155B11E682K | ○ | MURATA | 1005 | 6800pF | ±10% | DC25V
GRM155B11E822K | ○ | MURATA | 1005 | 8200pF | ±10% | DC25V
GRM155B11E103K | ○ | MURATA | 1005 | 0.01uF | ±10% | DC25V
GRM155B31H103K | ○ | MURATA | 1005 | 0.01uF | ±10% | DC50V
GRM155B11C153K | ○ | MURATA | 1005 | 0.015uF | ±10% | DC16V
GRM155B31H153K | ○ | MURATA | 1005 | 0.015uF | ±10% | DC50V
GRM155B11C183K | ○ | MURATA | 1005 | 0.018uF | ±10% | DC16V
GRM155B11E223K | ○ | MURATA | 1005 | 0.022uF | ±10% | DC25V
GRM155B11C223K | ○ | MURATA | 1005 | 0.022uF | ±10% | DC16V
GRM155B11A333K | ○ | MURATA | 1005 | 0.033uF | ±10% | DC10V
GRM155B31E333K | ○ | MURATA | 1005 | 0.033uF | ±10% | DC25V
GRM155B11A473K | ○ | MURATA | 1005 | 0.047uF | ±10% | DC10V
GRM155B11C473K | ○ | MURATA | 1005 | 0.047uF | ±10% | DC16V
GRM155B11A563K | ○ | MURATA | 1005 | 0.056uF | ±10% | DC10V
GRM155B11A683K | ○ | MURATA | 1005 | 0.068uF | ±10% | DC10V
GRM155B11A823K | ○ | MURATA | 1005 | 0.082uF | ±10% | DC10V
GRM155B11A104K | ○ | MURATA | 1005 | 0.1uF | ±10% | DC10V
GRM155B31C104K | ○ | MURATA | 1005 | 0.1uF | ±10% | DC16V
GRM155B31A474K | ○ | MURATA | 1005 | 0.47uF | ±10% | DC10V
GRM155B30J105K | ○ | MURATA | 1005 | 1uF | ±10% | DC6.3V
