mm011106/509_circuit/509_CoilDriver_24ch_CKT.pdf

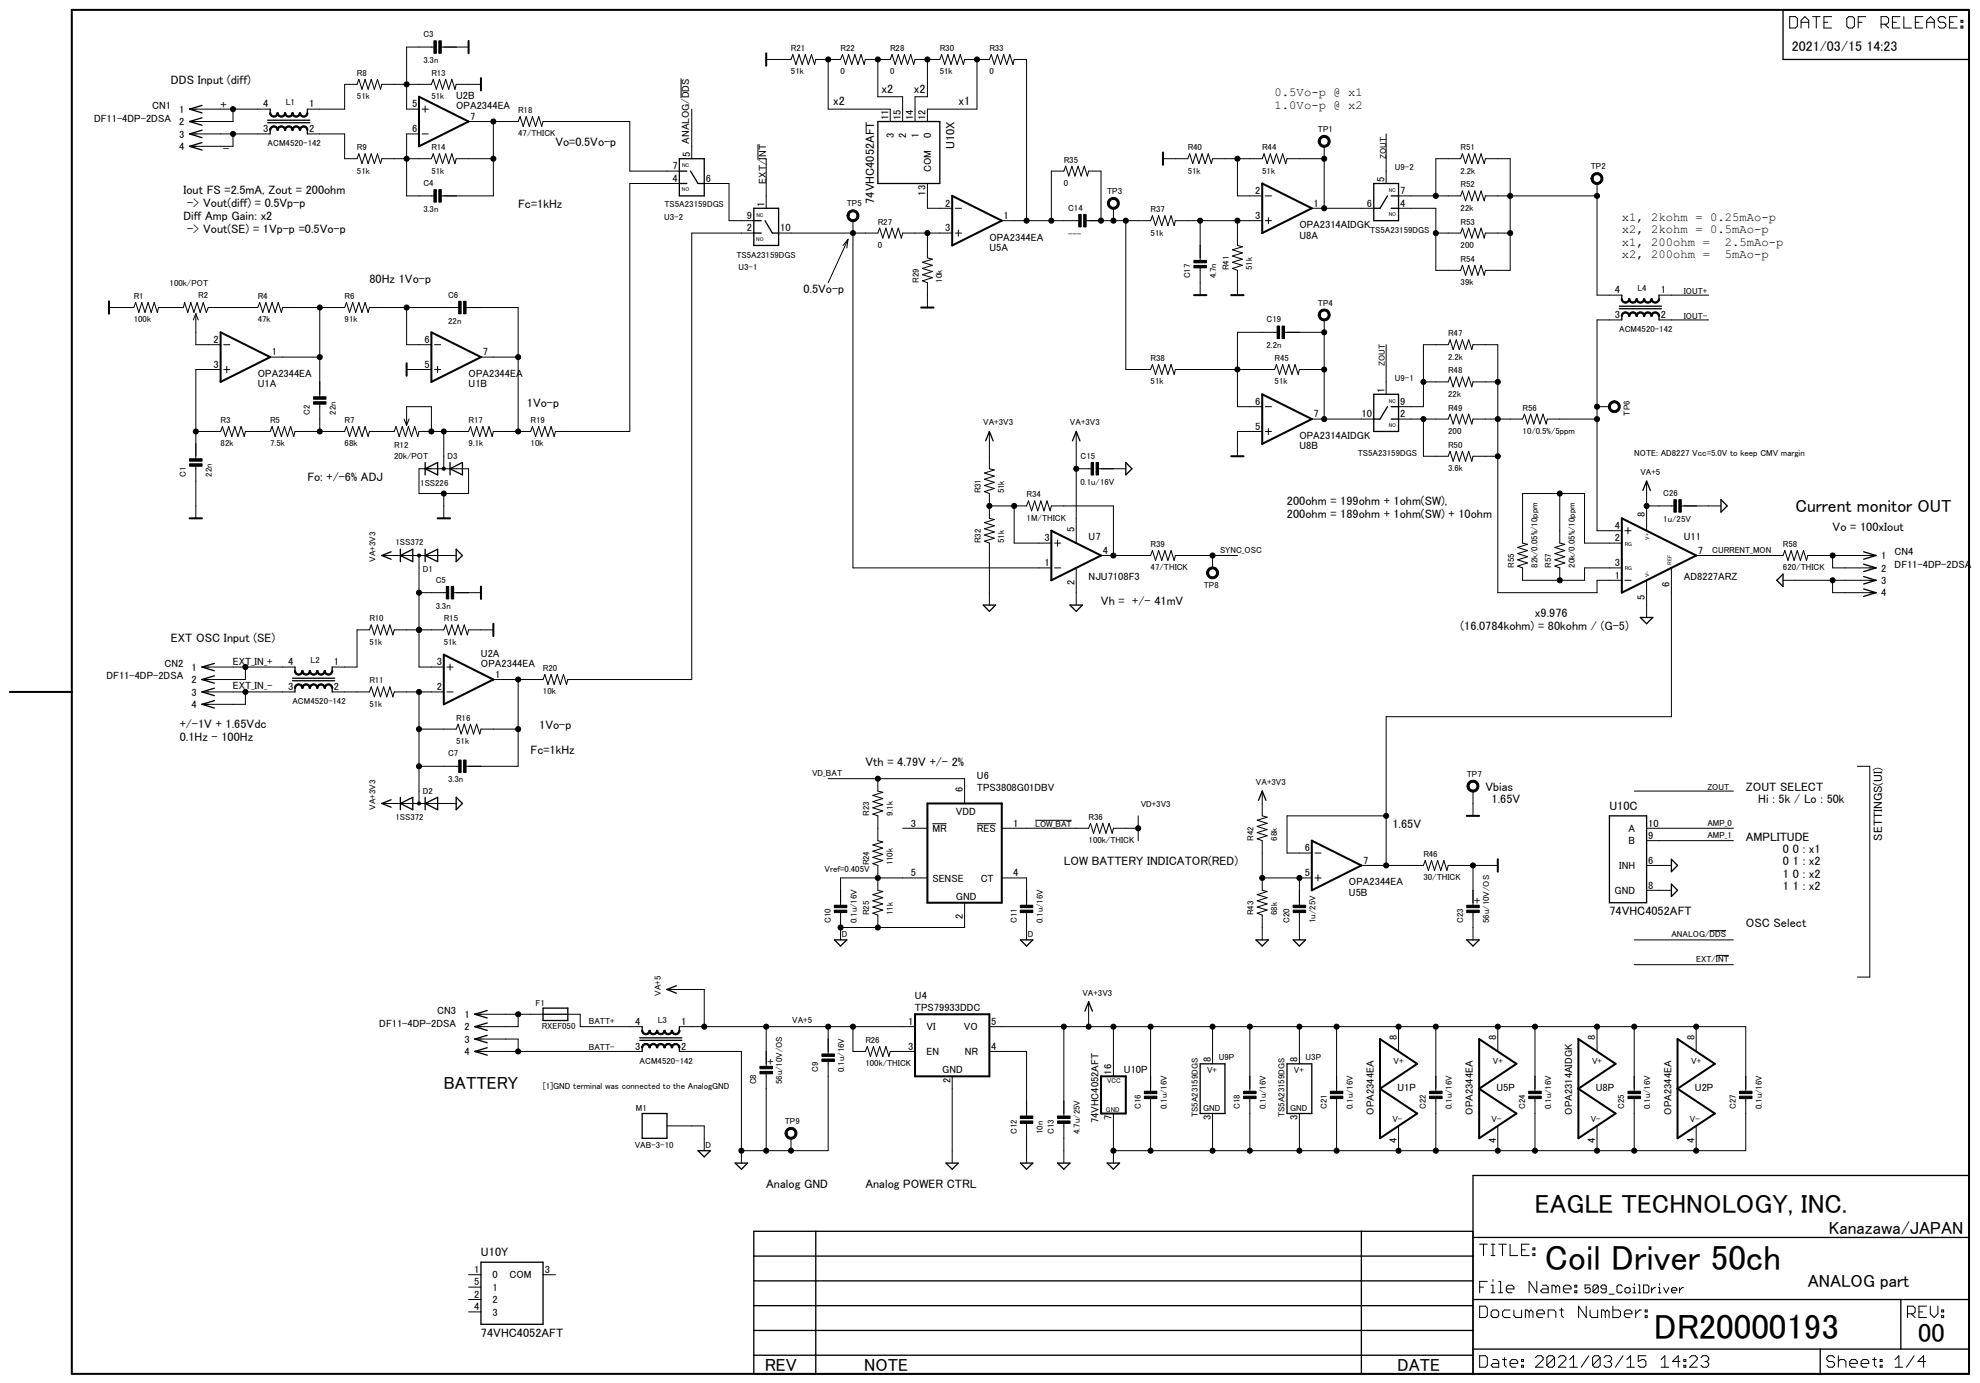
[picture p1: page 1]

Iout FS =2.5mA, Zout = 200ohm
-> Vout(diff) = 0.5Vp-p Diff Amp Gain: x2

NOTE: AD8227 Vcc=5.0V to keep CMV margin

EXT OSC Input (SE)

100k/THICK
LOW BATTERY INDICATOR(RED)

EAGLE TECHNOLOGY, INC. Kanazawa/JAPAN
Coil Driver 50ch

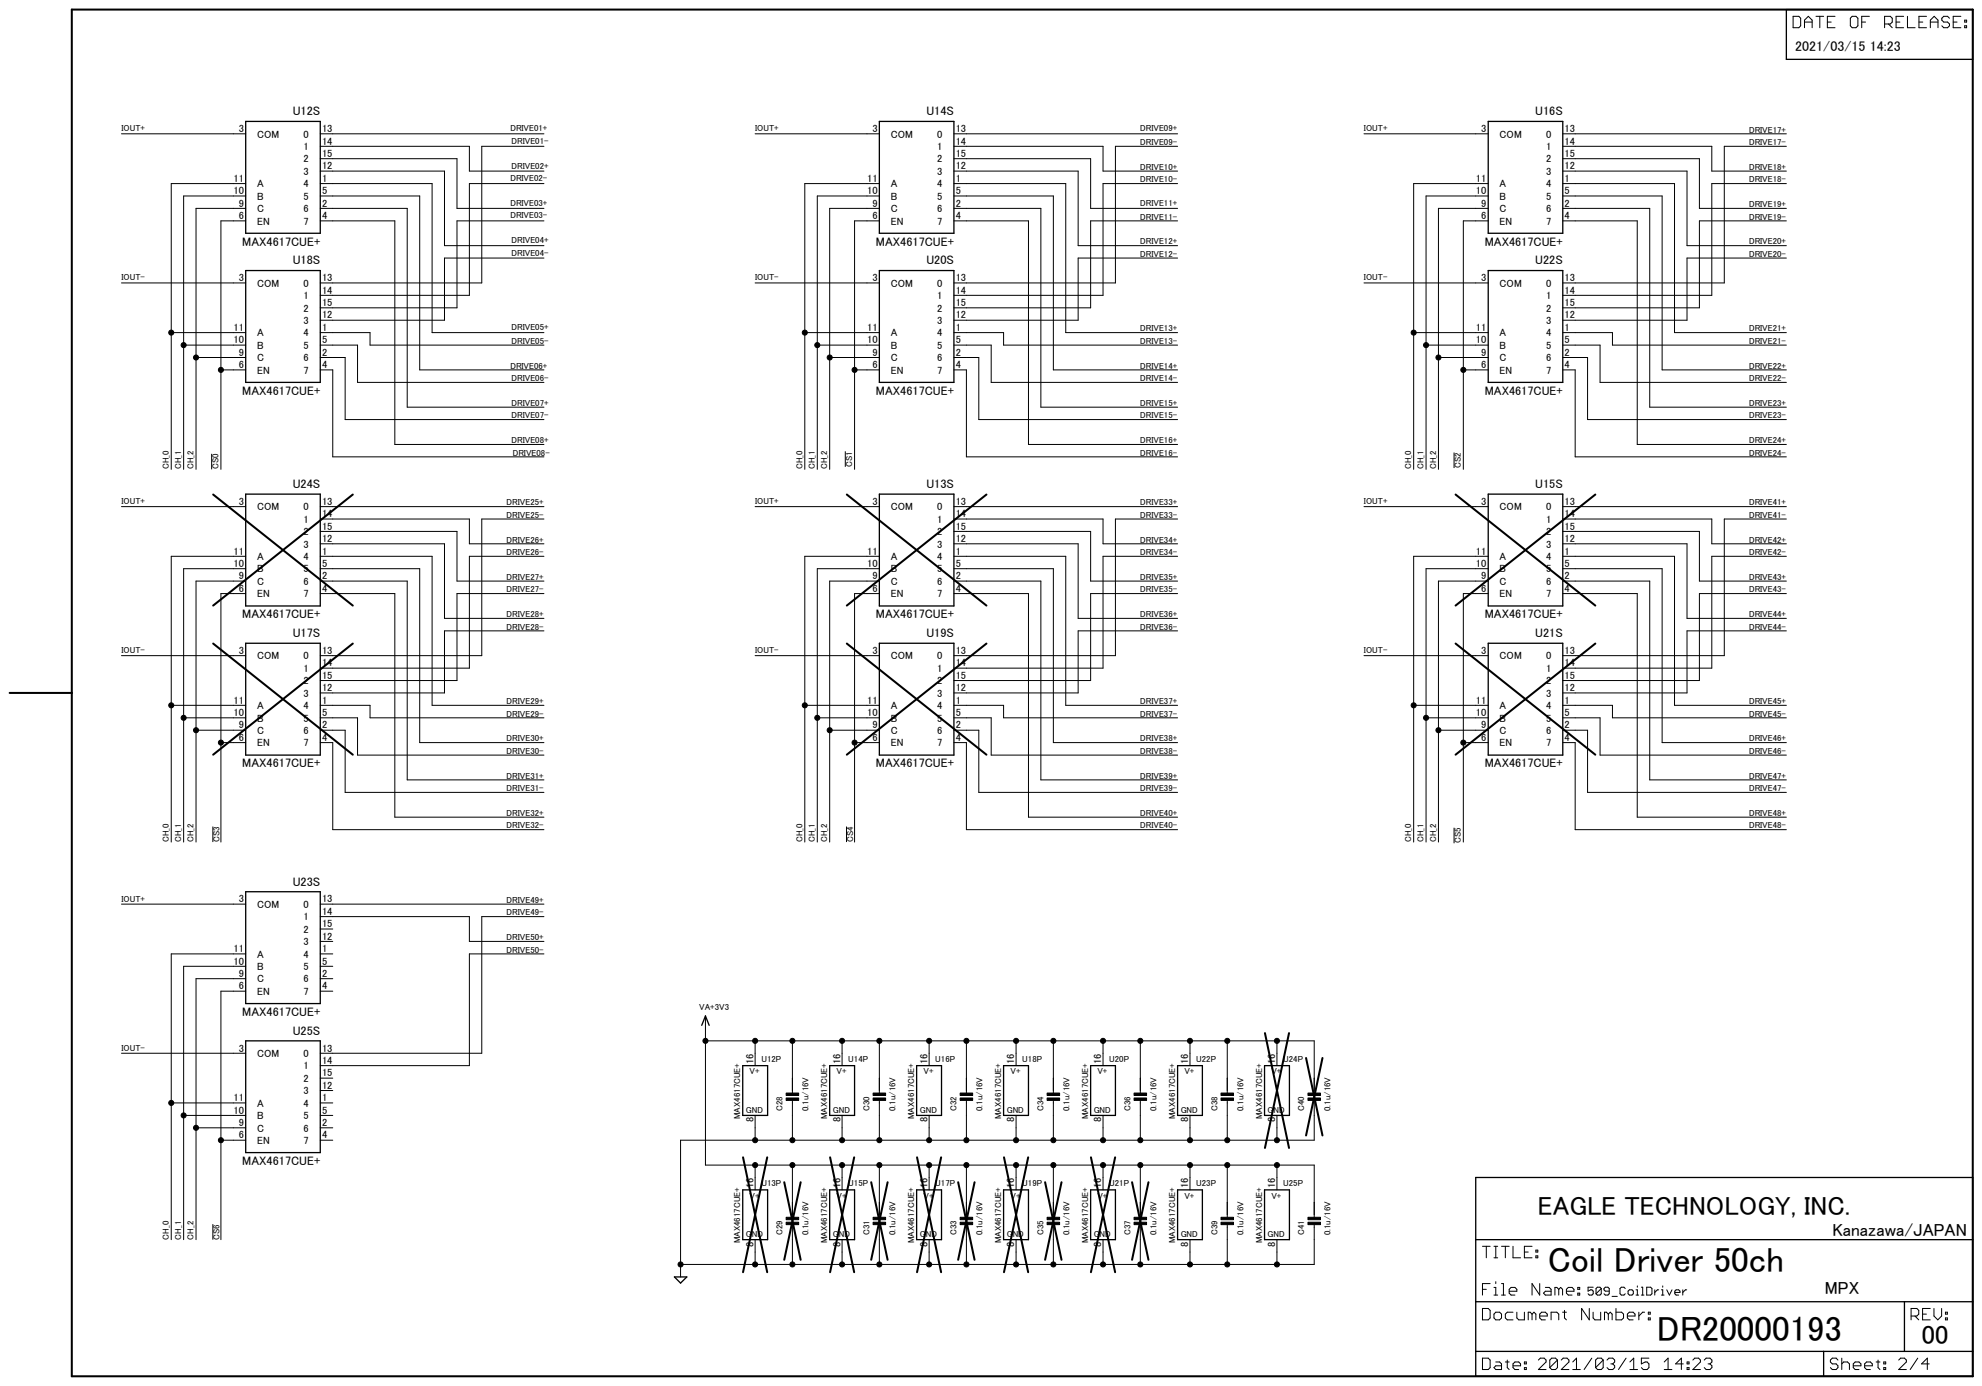
[picture p2: page 2]

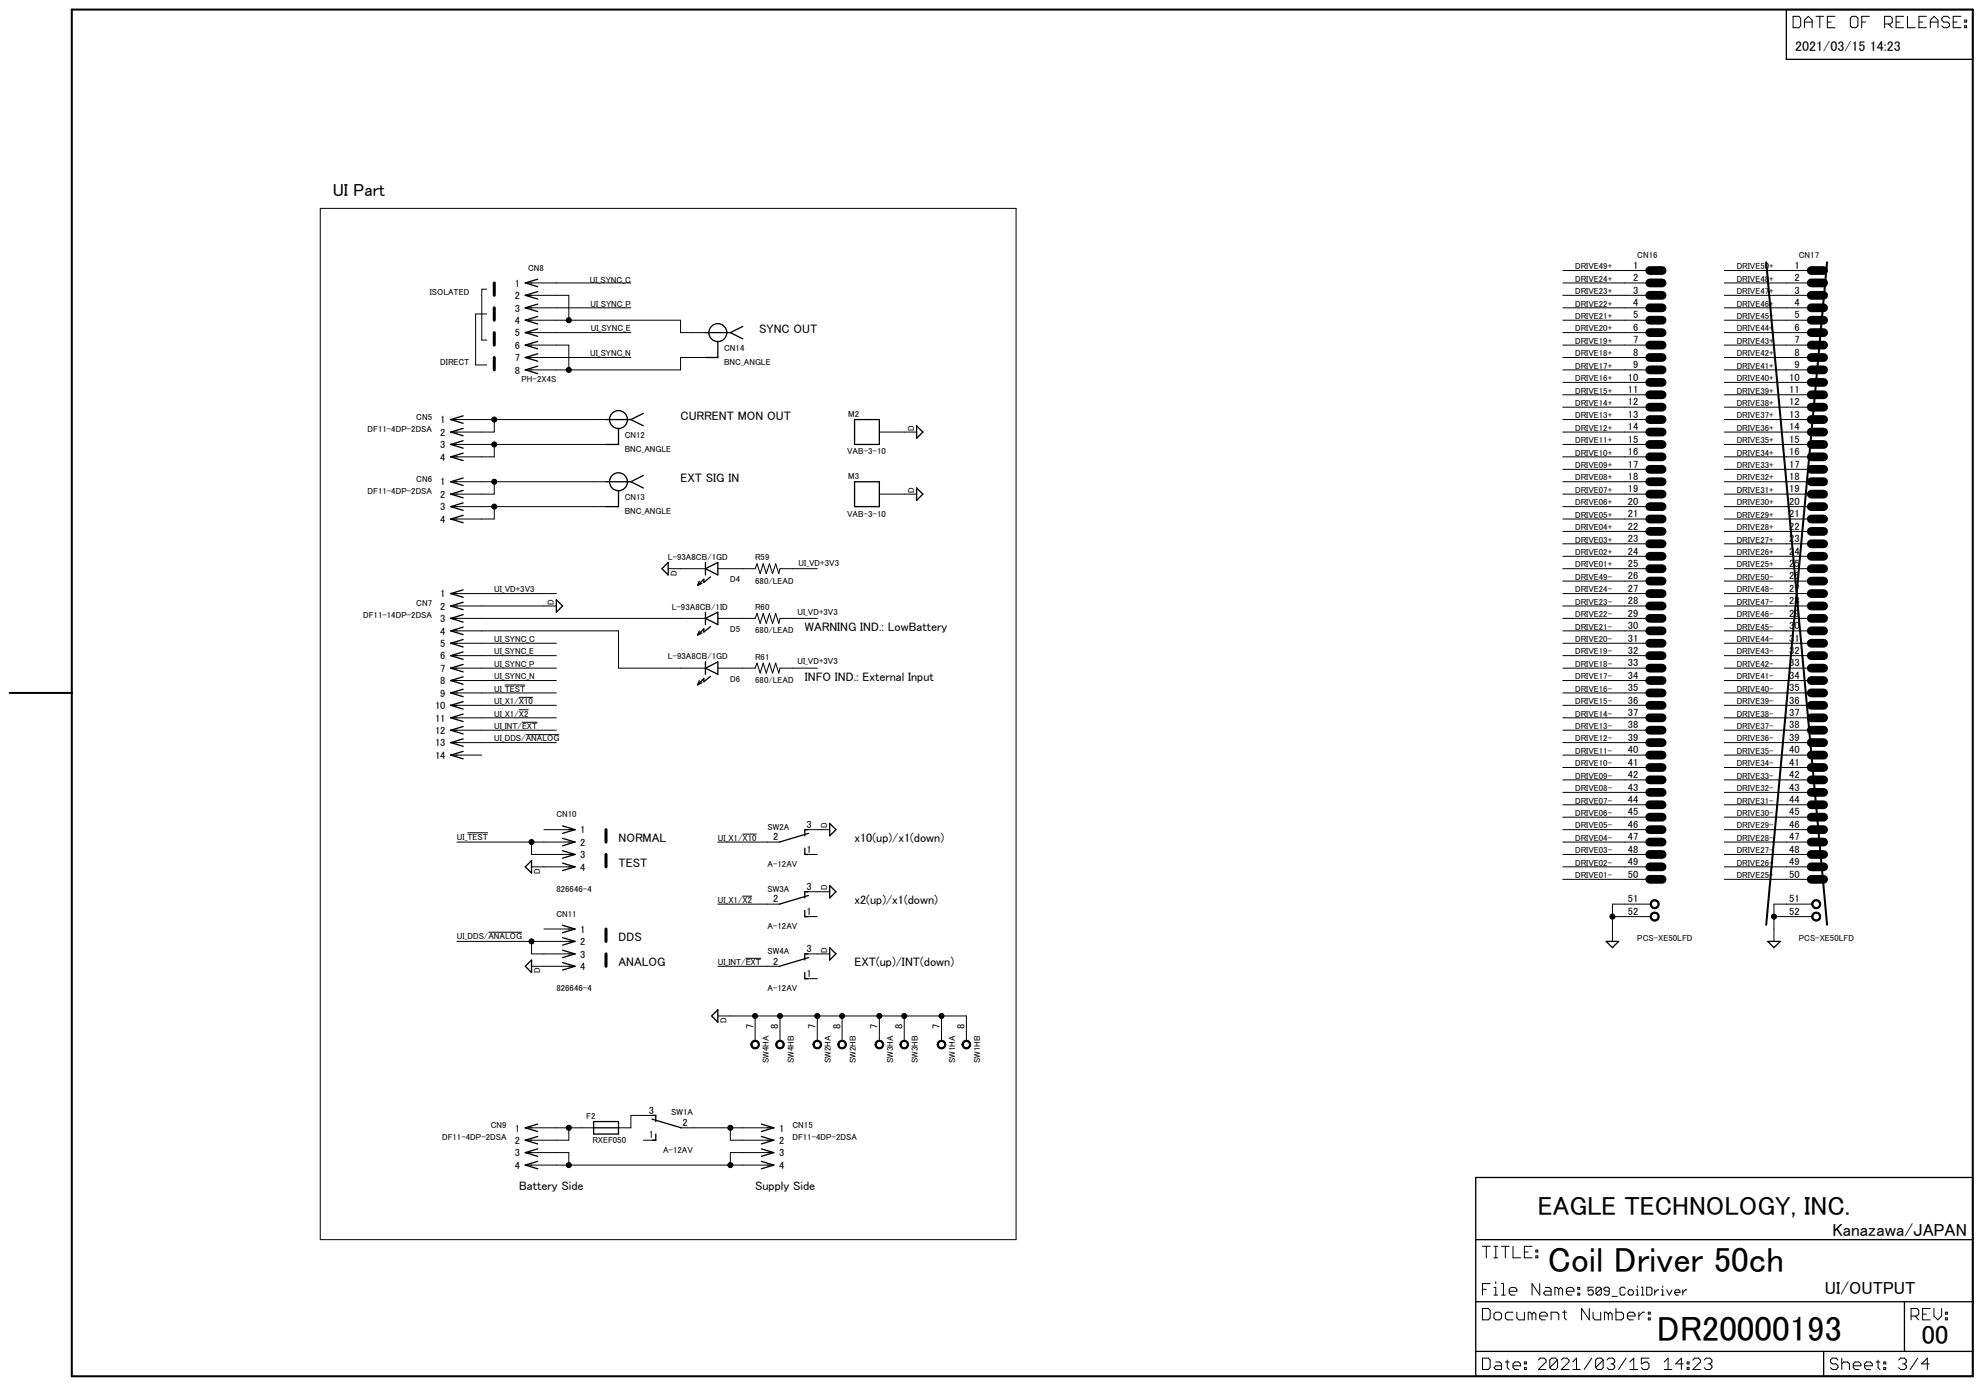
[picture p3: page 3]

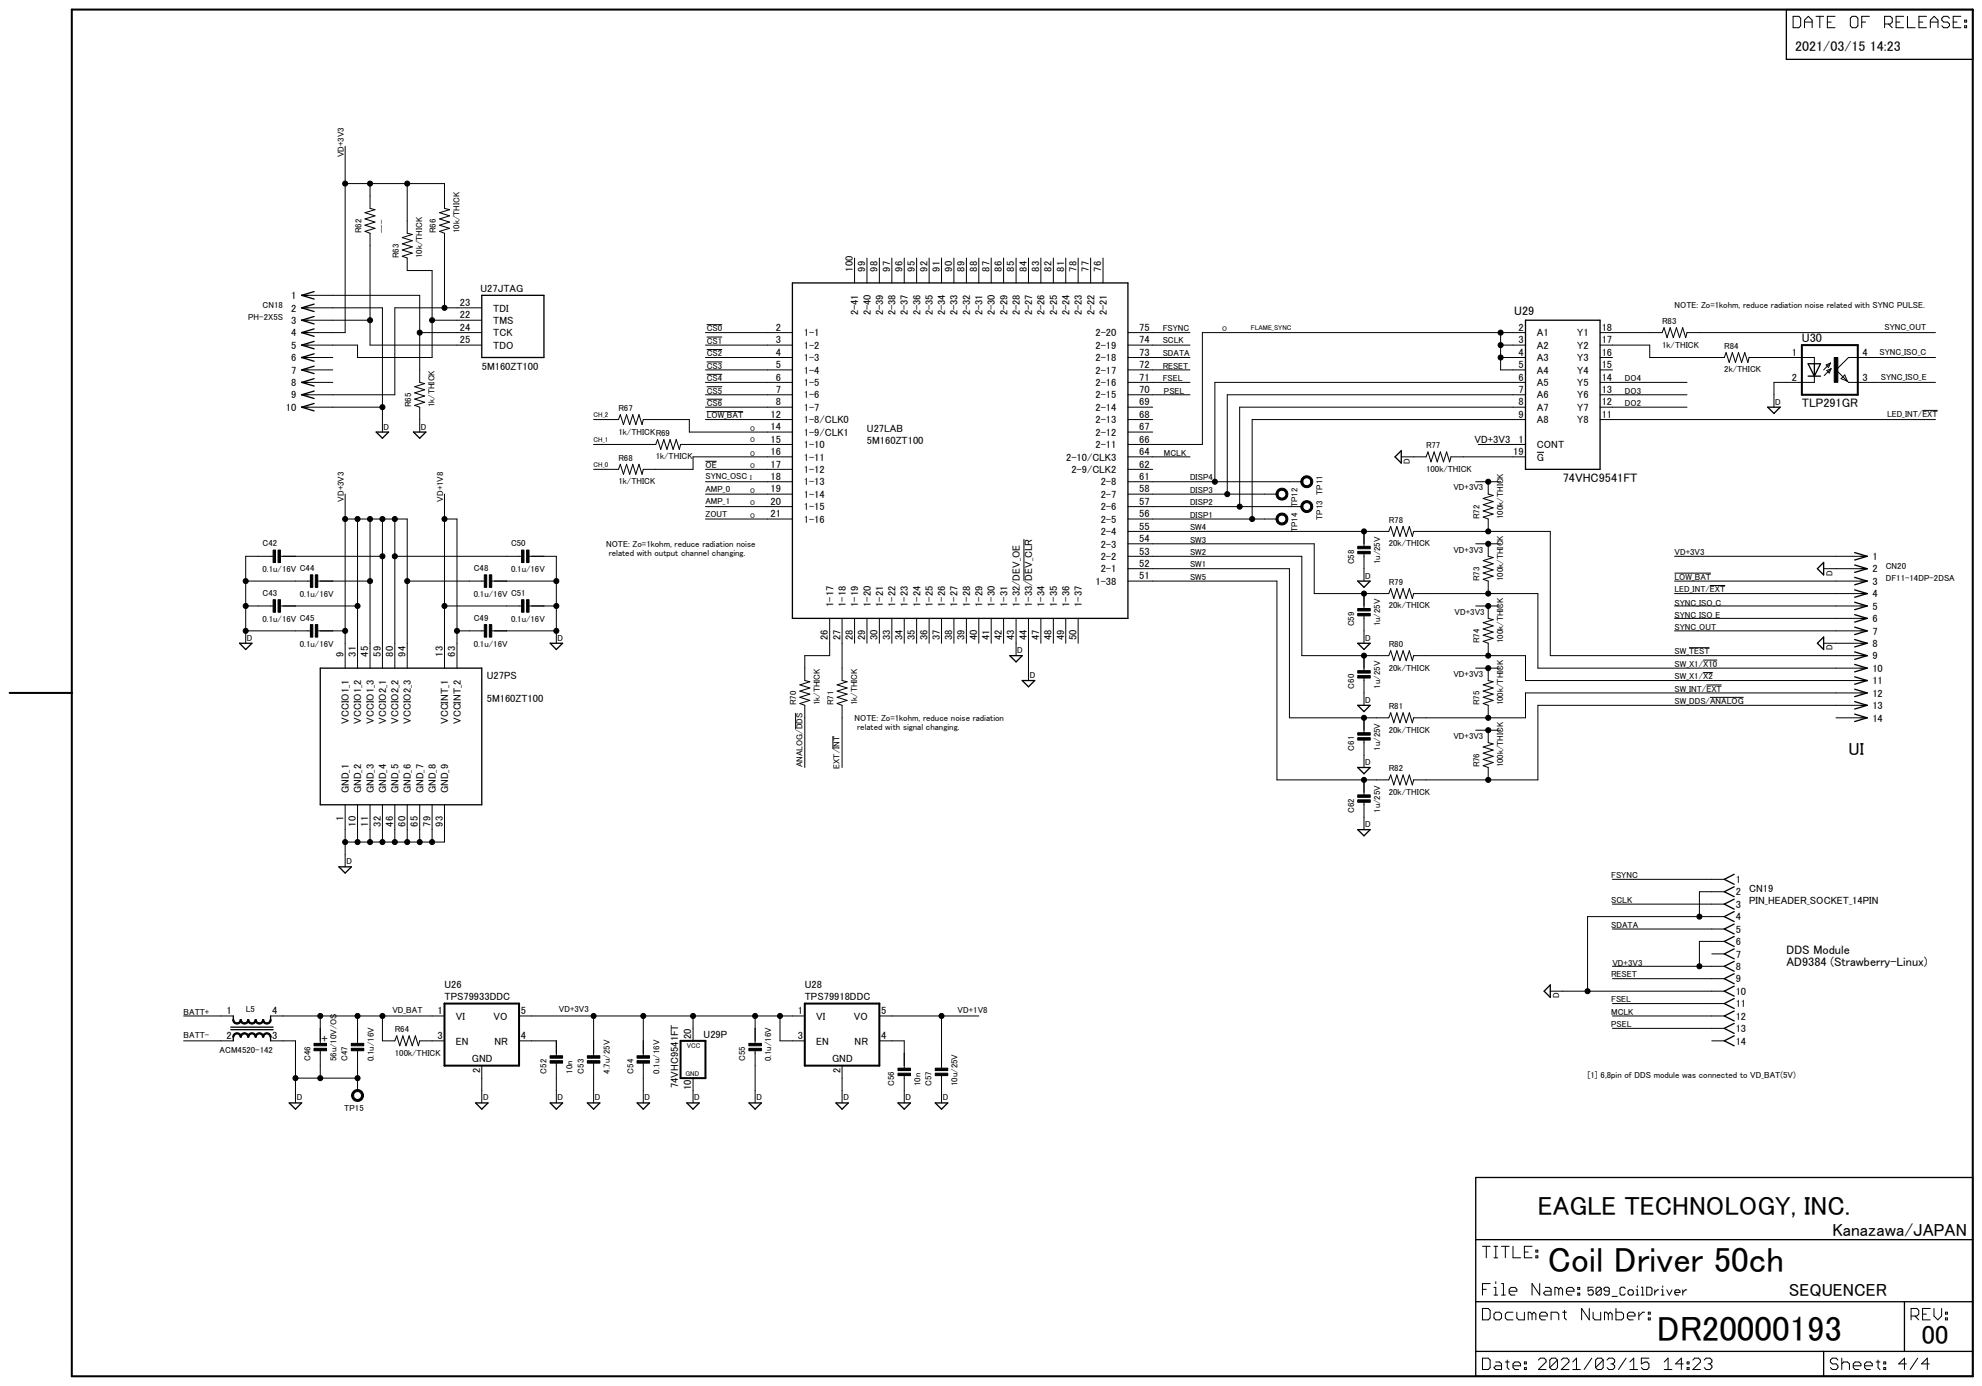
[picture p4: page 4]

NOTE: Zo=1kohm, reduce radiation noise related with SYNC PULSE.

NOTE: Zo=1kohm, reduce radiation noise
related with output channel changing.

EXT/INT ANALOG/DDS

NOTE: Zo=1kohm, reduce noise radiation
related with signal changing.

DDS Module AD9384 (Strawberry-Linux)

[1] 6,8pin of DDS module was connected to VD_BAT(5V)

EAGLE TECHNOLOGY, INC. Kanazawa/JAPAN
Coil Driver 50ch
