mm011106/509_circuit/509_CoilDriver.brd

## EAGLE design 509_CoilDriver.brd (2021-03-15)

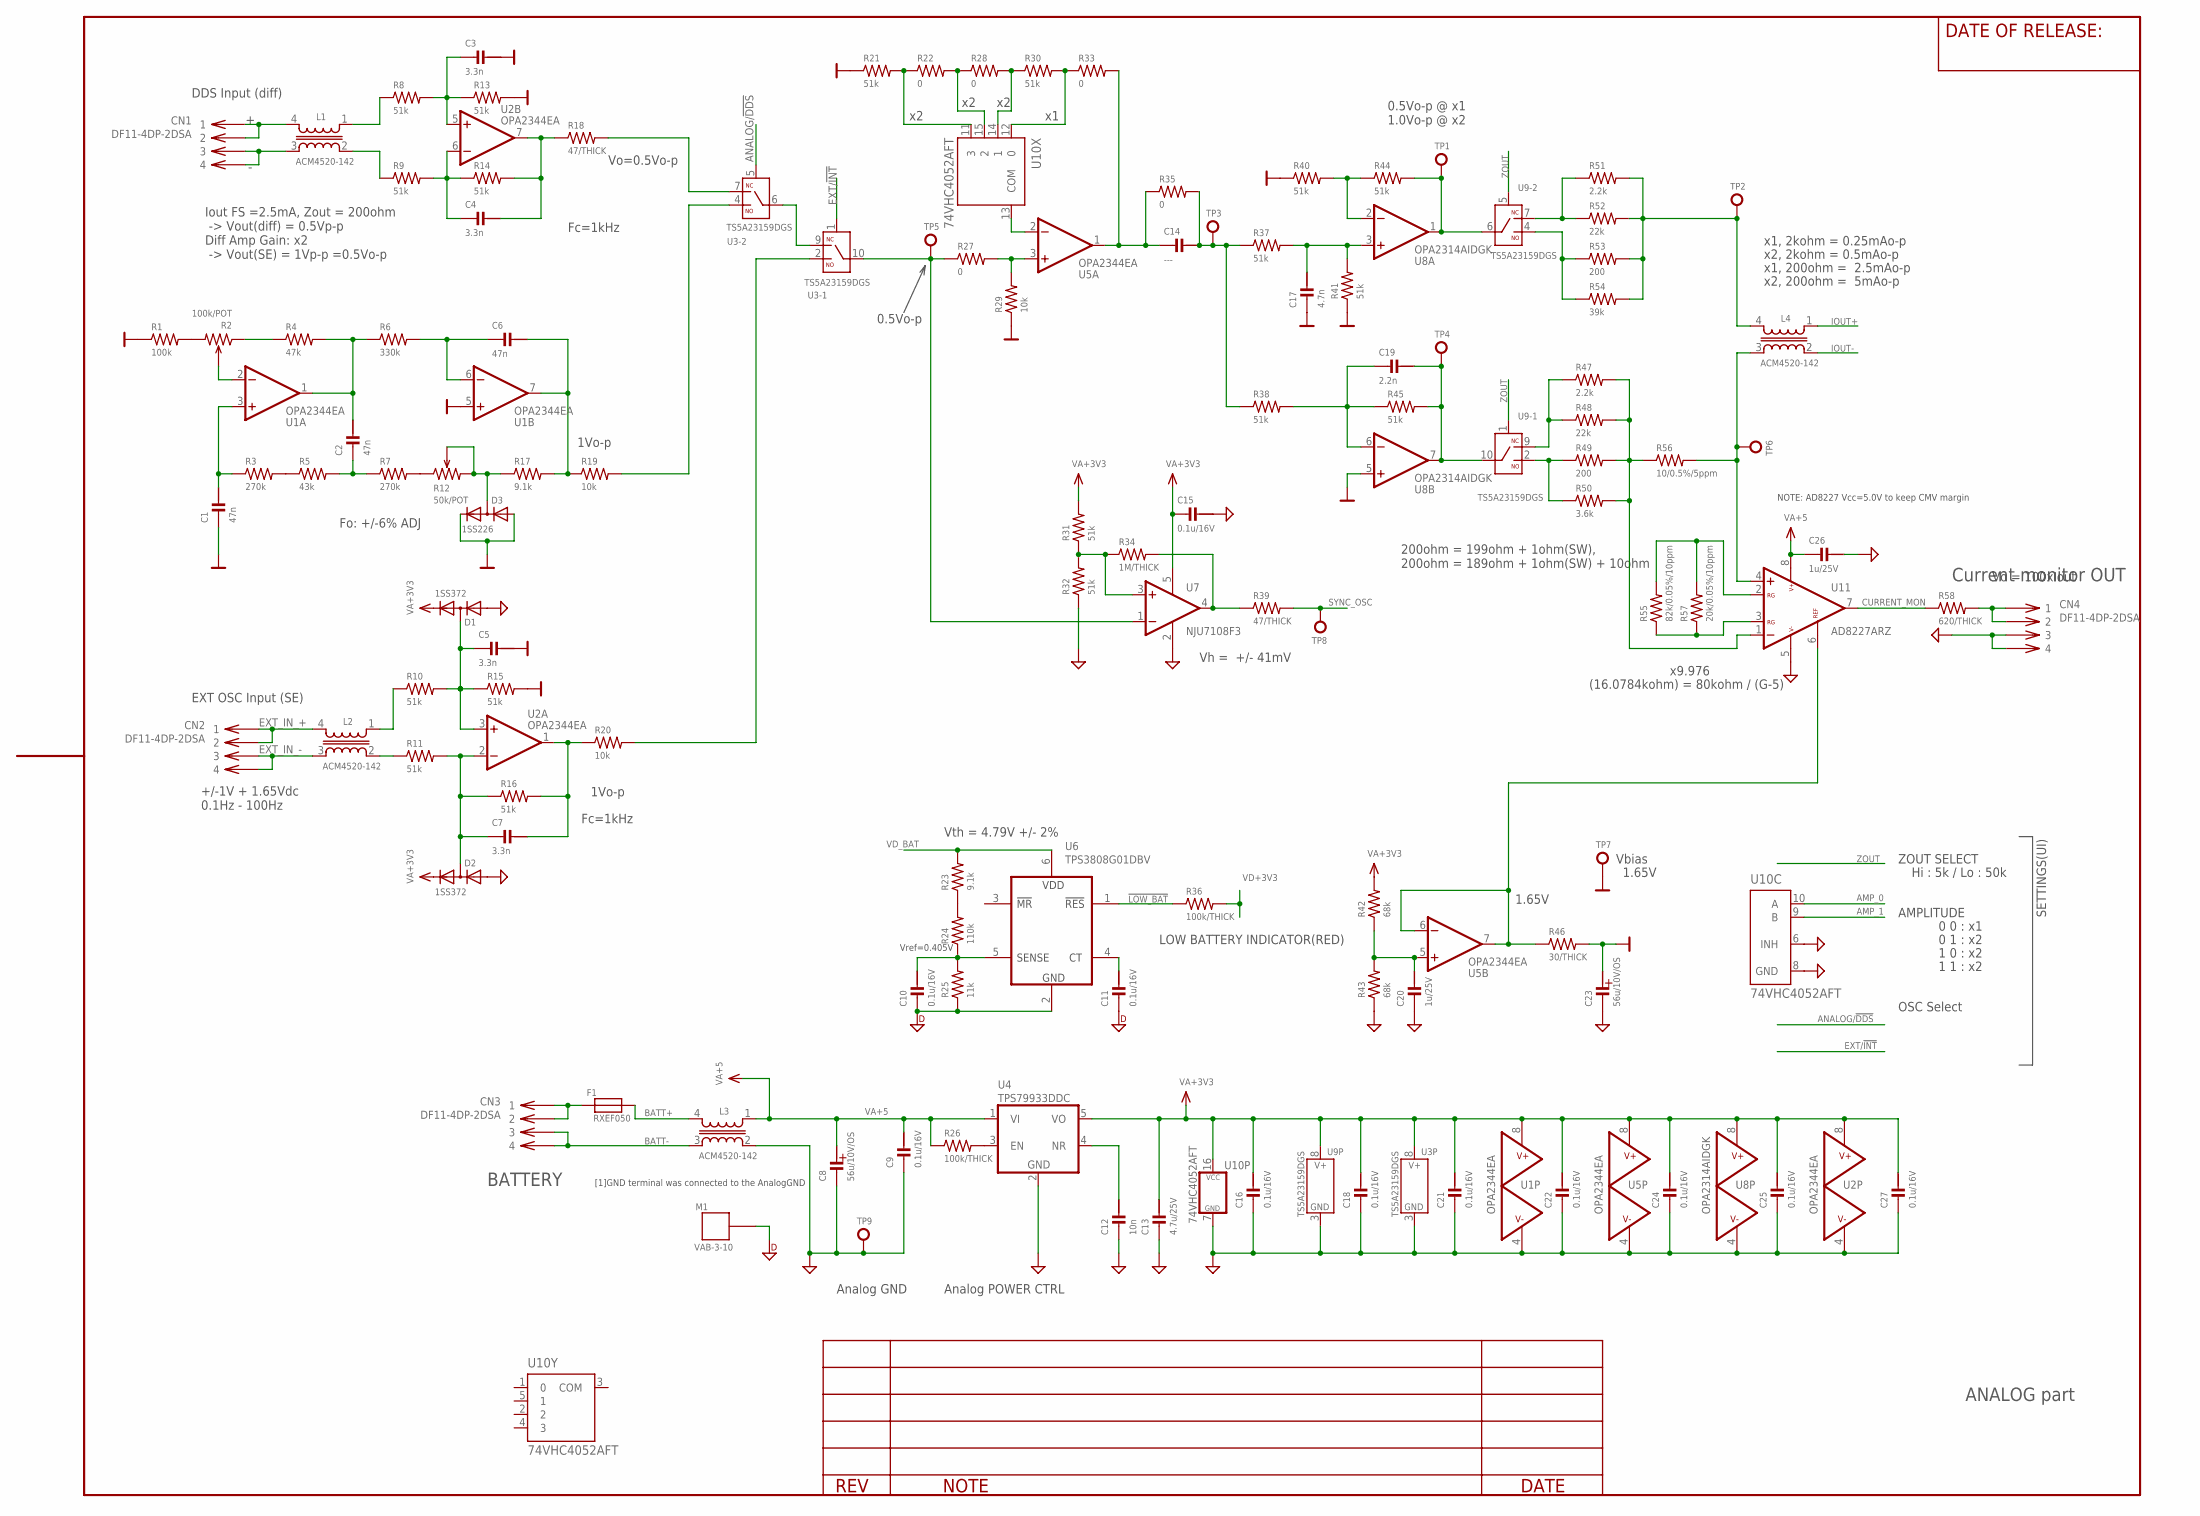
[picture p5: schematic 509_CoilDriver.sch, sheet 1]

Parts:
C1, C2, C6: 47n; CM3216
C3, C4, C5, C7: 3.3n; CM2012
C8, C23: 56u/10V/OS; PHI_6.3
C9, C10, C11, C15, C16, C18, C21, C22, C24, C25, C27: 0.1u/16V; CM1005
C12: 10n; CM2012
C13: 4.7u/25V; CM2012
C14: ---; CM3216
C17: 4.7n; CM2012
C19: 2.2n; CM2012
C20, C26: 1u/25V; CM1608
CN1, CN2, CN3, CN4: DF11-4DP-2DSA
D1, D2: 1SS372; SC70-3-R
D3: 1SS226; SOT23
F1: RXEF050; 8X3/5.08
L1, L2, L3, L4: ACM4520-142; ACM4520
M1: VAB-3-10; VAB_3_10_CONTACT
R1: 100k; RM1608
R2: 100k/POT; CT-6
R3, R7: 270k; RM1608
R4: 47k; RM1608
R5: 43k; RM1608
R6: 330k; RM1608
R8, R9, R10, R11, R13, R14, R15, R16, R21, R30, R31, R32, R37, R38, R40, R41, R44, R45: 51k; RM1608
R12: 50k/POT; CT-6
R17, R23: 9.1k; RM1608
R18, R39: 47/THICK; RM1608
R19, R20, R29: 10k; RM1608
R22, R27, R28, R33, R35: 0; RM1608
R24: 110k; RM1608
R25: 11k; RM1608
R26, R36: 100k/THICK; RM1608
R34: 1M/THICK; RM1608
R42, R43: 68k; RM1608
R46: 30/THICK; RM1608
R47, R51: 2.2k; RM1608
R48, R52: 22k; RM1608
R49, R53: 200; RM1608
R50: 3.6k; RM1608
R54: 39k; RM1608
R55: 82k/0.05%/10ppm; RM1608
R56: 10/0.5%/5ppm; RM1608
R57: 20k/0.05%/10ppm; RM1608
R58: 620/THICK; RM1608
TP1, TP2, TP3, TP4, TP5, TP6, TP7, TP8, TP9: TP-LC3G; TP_TH_0R9MM
U1, U2, U5: OPA2344EA; MSO8_AEL
U3, U9: TS5A23159DGS; MSOP10
U4: TPS79933DDC; SOT-23-5
U6: TPS3808G01DBV; SOT-23
U7: NJU7108F3; SC88A
U8: OPA2314AIDGK; MSO8_AEL
U10: 74VHC4052AFT; TSSOP16-P-044-065A
U11: AD8227ARZ; SO8_AEL

Connections:
0V: C1.2, C3.1, C5.1, C17.2, C23.POS, D3.1 (A), D3.2 (C), R1.1, R13.2, R15.2, R21.1, R29.1, R40.1, R41.1, R46.2, TP7.1, U1.5 (+IN), U8.5 (+IN)
80_POWER: R26.2, U4.3 (EN)
!LOW_BAT: R36.1, U6.1 (!RESET); also elsewhere on the board
AGND: C8.NEG, C9.2, C12.2, C13.2, C15.1, C16.2, C18.2, C20.2, C21.2, C22.2, C23.NEG, C24.2, C25.2, C26.1, C27.2, CN4.3, CN4.4, D1.1 (A), D2.1 (A), L3.2 (3), R32.1, R43.1, TP9.1, U1.4 (V-), U2.4 (V-), U3.3 (V-), U4.2 (GND), U5.4 (V-), U7.2 (V-), U8.4 (V-), U9.3 (V-), U10.6 (INH), U10.7 (GND), U10.8 (GND), U11.5 (V-); also elsewhere on the board
AMP_0: U10.10 (A); also elsewhere on the board
AMP_1: U10.9 (B); also elsewhere on the board
ANALOG/!DDS!: U3.5 (IN); also elsewhere on the board
BATT+: F1.2, L3.4 (2); also elsewhere on the board
BATT-: CN3.3, CN3.4, L3.3 (4); also elsewhere on the board
CURRENT_MON: R58.1, U11.7 (OUT)
DGND: C10.2, C11.2, M1.CASE1, R25.1, U6.2 (GND); also elsewhere on the board
EXT/!INT!: U3.1 (IN); also elsewhere on the board
EXT_IN_+: CN2.1, CN2.2, L2.4 (2)
EXT_IN_-: CN2.3, CN2.4, L2.3 (4)
IOUT+: L4.1; also elsewhere on the board
IOUT-: L4.2 (3); also elsewhere on the board
unnamed: L2.1, R10.1
unnamed: U3.6 (COM), U3.9 (NC)
unnamed: R7.2, R12.1
unnamed: C3.2, R8.2, R13.1, U2.5 (+IN)
unnamed: R1.2, R2.3
unnamed: C7.2, D2.3 (AC), R11.2, R16.1, U2.2 (-IN)
unnamed: C6.1, R17.2, R19.1, U1.7 (OUT)
unnamed: L4.3 (4), R56.2, TP6.1, U11.4 (+IN)
unnamed: L4.4 (2), R51.2, R52.2, R53.2, R54.2, TP2.1
unnamed: R21.2, R22.1, U10.11 (3)
unnamed: C7.1, R16.2, R20.1, U2.1 (OUT)
unnamed: R22.2, R28.1, U10.15 (2)
unnamed: R28.2, R30.1, U10.14 (1)
unnamed: C5.2, D1.3 (AC), R10.2, R15.1, U2.3 (+IN)
unnamed: L1.2 (3), R9.1
unnamed: R30.2, R33.1, U10.12 (0)
unnamed: C20.1, R42.1, R43.2, U5.5 (+IN)
unnamed: C19.2, R38.2, R45.1, U8.6 (-IN)
unnamed: U5.2 (-IN), U10.13 (COM)
unnamed: C14.2, R33.2, R35.1, U5.1 (OUT)
unnamed: R27.2, R29.2, U5.3 (+IN)
unnamed: C19.1, R45.2, TP4.1, U8.7 (OUT), U9.10 (COM)
unnamed: R44.2, TP1.1, U8.1 (OUT), U9.6 (COM)
unnamed: R40.2, R44.1, U8.2 (-IN)
unnamed: C17.1, R37.2, R41.2, U8.3 (+IN)
unnamed: R49.1, R50.1, U9.2 (NO)
unnamed: R47.1, R48.1, U9.9 (NC)
unnamed: R47.2, R48.2, R49.2, R50.2, R56.1, U11.1 (-IN)
unnamed: R51.1, R52.1, U9.7 (NC)
unnamed: R53.1, R54.1, U9.4 (NO)
unnamed: C4.1, R14.2, R18.1, U2.7 (OUT)
unnamed: R2.1, R4.1
unnamed: C2.1, R4.2, R6.1, U1.1 (OUT)
unnamed: C6.2, R6.2, U1.6 (-IN)
unnamed: R2.2, U1.2 (-IN)
unnamed: C1.1, R3.1, U1.3 (+IN)
unnamed: R3.2, R5.1
unnamed: C2.2, R5.2, R7.1
unnamed: D3.3 (AC), R12.2, R12.3, R17.1
unnamed: C14.1, R35.2, R37.1, R38.1, TP3.1
unnamed: C4.2, R9.2, R14.1, U2.6 (-IN)
unnamed: CN1.3, CN1.4, L1.3 (4)
unnamed: CN1.1, CN1.2, L1.4 (2)
unnamed: R31.1, R32.2, R34.1, U7.3 (+IN)
unnamed: R34.2, R39.1, U7.4 (OUT)
unnamed: CN3.1, CN3.2, F1.1
unnamed: C11.1, U6.4 (CT)
unnamed: L1.1, R8.1
unnamed: C10.1, R24.1, R25.2, U6.5 (SENSE)
unnamed: CN4.1, CN4.2, R58.2
unnamed: C12.1, U4.4 (NR)
unnamed: L2.2 (3), R11.1
unnamed: R20.2, U3.2 (NO)
unnamed: R18.2, U3.7 (NC)
unnamed: R27.1, TP5.1, U3.10 (COM), U7.1 (-IN)
unnamed: R19.2, U3.4 (NO)
unnamed: R23.1, R24.2
unnamed: R55.1, R57.1, U11.3 (RG2)
unnamed: R55.2, R57.2, U11.2 (RG1)
unnamed: R46.1, U5.6 (-IN), U5.7 (OUT), U11.6 (REF)
SYNC_OSC: R39.2, TP8.1; also elsewhere on the board
VA+3V3: C13.1, C15.2, C16.1, C18.1, C21.1, C22.1, C24.1, C25.1, C27.1, D1.2 (C), D2.2 (C), R31.2, R42.2, U1.8 (V+), U2.8 (V+), U3.8 (V+), U4.5 (VO), U5.8 (V+), U7.5 (V+), U8.8 (V+), U9.8 (V+), U10.16 (VCC); also elsewhere on the board
VA+5: C8.POS, C9.1, C26.2, L3.1, R26.1, U4.1 (VI), U11.8 (V+)
VD+3V3: R36.2; also elsewhere on the board
VD_BAT: R23.2, U6.6 (VDD); also elsewhere on the board
ZOUT: U9.1 (IN), U9.5 (IN); also elsewhere on the board

Notes on the sheet:
ANALOG part
AMPLITUDE
ZOUT SELECT
Hi : 5k / Lo : 50k
0 0 : x1
0 1 : x2
1 0 : x2
1 1 : x2
LOW BATTERY INDICATOR(RED)
Vth = 4.79V +/- 2%
Vref=0.405V
Analog GND
Analog POWER CTRL
1.65V
Vh = +/- 41mV
Vbias
Fo: +/-6% ADJ
x1, 2kohm = 0.25mAo-p
x2, 2kohm = 0.5mAo-p
x1, 200ohm = 2.5mAo-p
x2, 200ohm = 5mAo-p
0.5Vo-p
x9.976
DDS Input (diff)
Vo=0.5Vo-p
Fc=1kHz
[1]GND terminal was connected to the AnalogGND
BATTERY
Current monitor OUT
NOTE: AD8227 Vcc=5.0V to keep CMV margin
Vo = 100xIout
Iout FS =2.5mA, Zout = 200ohm -> Vout(diff) = 0.5Vp-p Diff Amp Gain: x2 -> Vout(SE) = 1Vp-p =0.5Vo-p
1Vo-p
EXT OSC Input (SE)
+/-1V + 1.65Vdc 0.1Hz - 100Hz
OSC Select
200ohm = 199ohm + 1ohm(SW), 200ohm = 189ohm + 1ohm(SW) + 10ohm
SETTINGS(UI)
0.5Vo-p @ x1 1.0Vo-p @ x2
(16.0784kohm) = 80kohm / (G-5)

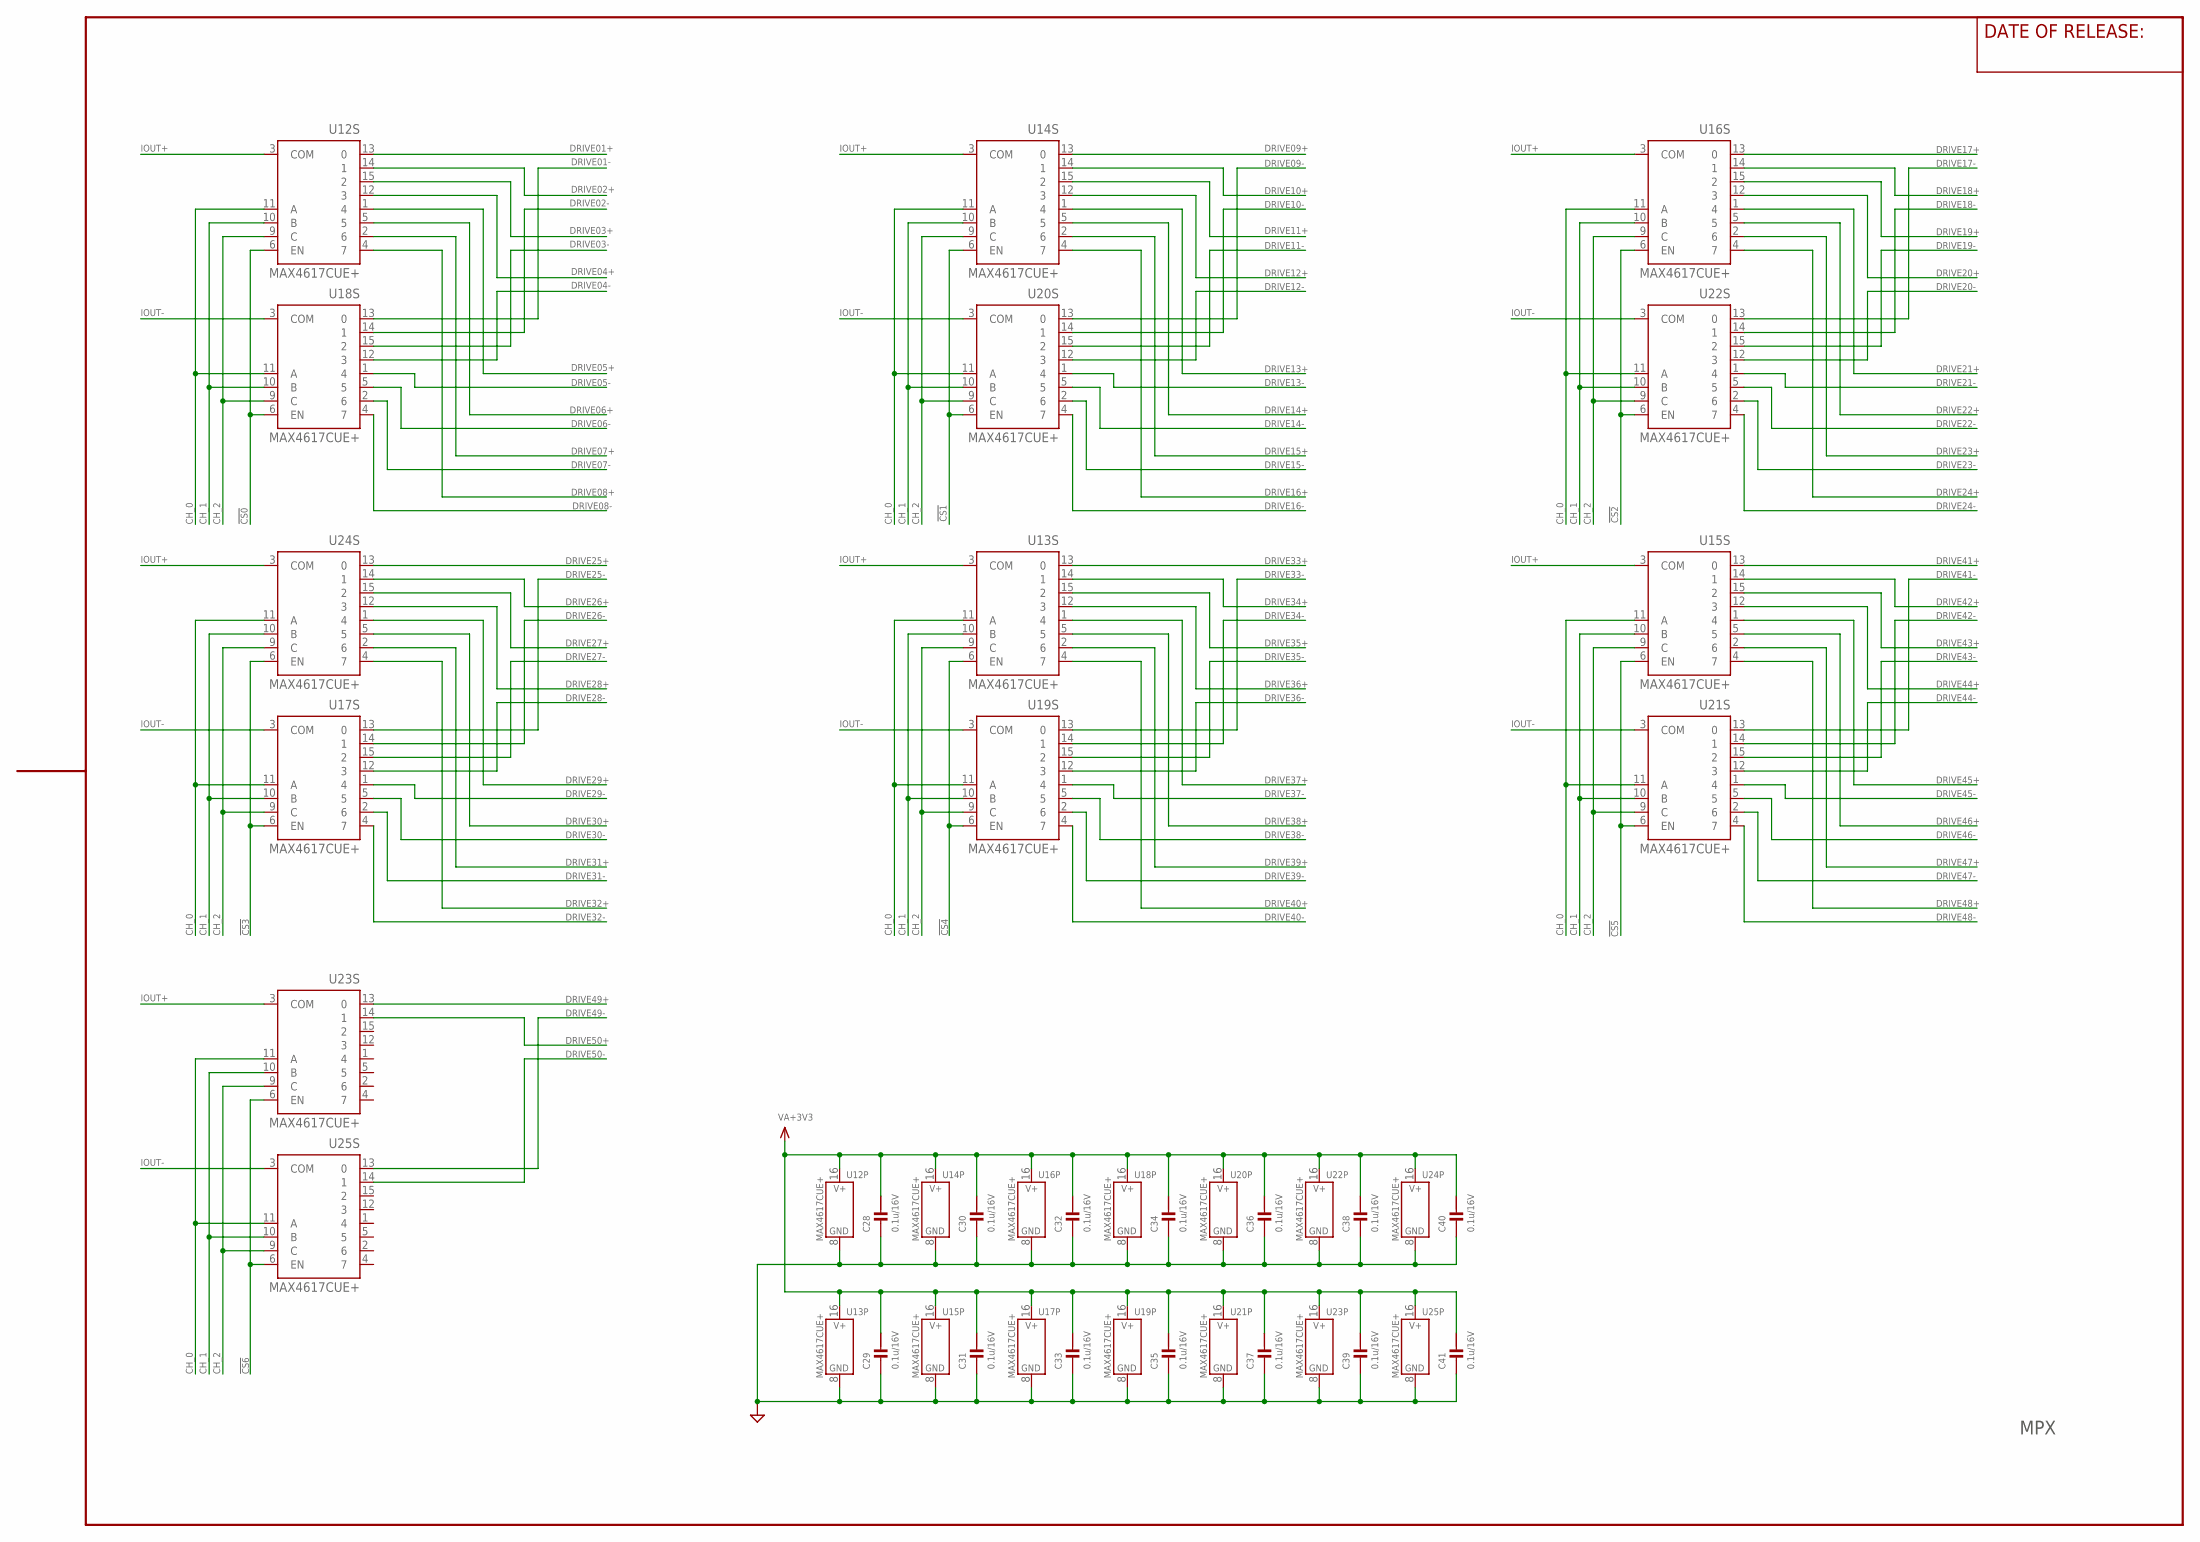
[picture p6: schematic 509_CoilDriver.sch, sheet 2]

Parts:
C28, C29, C30, C31, C32, C33, C34, C35, C36, C37, C38, C39, C40, C41: 0.1u/16V; CM1005
U12, U13, U14, U15, U16, U17, U18, U19, U20, U21, U22, U23, U24, U25: MAX4617CUE+; TSSOP16_AEL

Connections:
!CS0: U12.6 (EN), U18.6 (EN); also elsewhere on the board
!CS1: U14.6 (EN), U20.6 (EN); also elsewhere on the board
!CS2: U16.6 (EN), U22.6 (EN); also elsewhere on the board
!CS3: U17.6 (EN), U24.6 (EN); also elsewhere on the board
!CS4: U13.6 (EN), U19.6 (EN); also elsewhere on the board
!CS5: U15.6 (EN), U21.6 (EN); also elsewhere on the board
!CS6: U23.6 (EN), U25.6 (EN); also elsewhere on the board
AGND: C28.2, C29.2, C30.2, C31.2, C32.2, C33.2, C34.2, C35.2, C36.2, C37.2, C38.2, C39.2, C40.2, C41.2, U12.8 (V-), U13.8 (V-), U14.8 (V-), U15.8 (V-), U16.8 (V-), U17.8 (V-), U18.8 (V-), U19.8 (V-), U20.8 (V-), U21.8 (V-), U22.8 (V-), U23.8 (V-), U24.8 (V-), U25.8 (V-); also elsewhere on the board
CH_0: U12.11 (A), U13.11 (A), U14.11 (A), U15.11 (A), U16.11 (A), U17.11 (A), U18.11 (A), U19.11 (A), U20.11 (A), U21.11 (A), U22.11 (A), U23.11 (A), U24.11 (A), U25.11 (A); also elsewhere on the board
CH_1: U12.10 (B), U13.10 (B), U14.10 (B), U15.10 (B), U16.10 (B), U17.10 (B), U18.10 (B), U19.10 (B), U20.10 (B), U21.10 (B), U22.10 (B), U23.10 (B), U24.10 (B), U25.10 (B); also elsewhere on the board
CH_2: U12.9 (C), U13.9 (C), U14.9 (C), U15.9 (C), U16.9 (C), U17.9 (C), U18.9 (C), U19.9 (C), U20.9 (C), U21.9 (C), U22.9 (C), U23.9 (C), U24.9 (C), U25.9 (C); also elsewhere on the board
DRIVE01+: U12.13 (0); also elsewhere on the board
DRIVE01-: U18.13 (0); also elsewhere on the board
DRIVE02+: U12.14 (1); also elsewhere on the board
DRIVE02-: U18.14 (1); also elsewhere on the board
DRIVE03+: U12.15 (2); also elsewhere on the board
DRIVE03-: U18.15 (2); also elsewhere on the board
DRIVE04+: U12.12 (3); also elsewhere on the board
DRIVE04-: U18.12 (3); also elsewhere on the board
DRIVE05+: U12.1 (4); also elsewhere on the board
DRIVE05-: U18.1 (4); also elsewhere on the board
DRIVE06+: U12.5; also elsewhere on the board
DRIVE06-: U18.5; also elsewhere on the board
DRIVE07+: U12.2 (6); also elsewhere on the board
DRIVE07-: U18.2 (6); also elsewhere on the board
DRIVE08+: U12.4 (7); also elsewhere on the board
DRIVE08-: U18.4 (7); also elsewhere on the board
DRIVE09+: U14.13 (0); also elsewhere on the board
DRIVE09-: U20.13 (0); also elsewhere on the board
DRIVE10+: U14.14 (1); also elsewhere on the board
DRIVE10-: U20.14 (1); also elsewhere on the board
DRIVE11+: U14.15 (2); also elsewhere on the board
DRIVE11-: U20.15 (2); also elsewhere on the board
DRIVE12+: U14.12 (3); also elsewhere on the board
DRIVE12-: U20.12 (3); also elsewhere on the board
DRIVE13+: U14.1 (4); also elsewhere on the board
DRIVE13-: U20.1 (4); also elsewhere on the board
DRIVE14+: U14.5; also elsewhere on the board
DRIVE14-: U20.5; also elsewhere on the board
DRIVE15+: U14.2 (6); also elsewhere on the board
DRIVE15-: U20.2 (6); also elsewhere on the board
DRIVE16+: U14.4 (7); also elsewhere on the board
DRIVE16-: U20.4 (7); also elsewhere on the board
DRIVE17+: U16.13 (0); also elsewhere on the board
DRIVE17-: U22.13 (0); also elsewhere on the board
DRIVE18+: U16.14 (1); also elsewhere on the board
DRIVE18-: U22.14 (1); also elsewhere on the board
DRIVE19+: U16.15 (2); also elsewhere on the board
DRIVE19-: U22.15 (2); also elsewhere on the board
DRIVE20+: U16.12 (3); also elsewhere on the board
DRIVE20-: U22.12 (3); also elsewhere on the board
DRIVE21+: U16.1 (4); also elsewhere on the board
DRIVE21-: U22.1 (4); also elsewhere on the board
DRIVE22+: U16.5; also elsewhere on the board
DRIVE22-: U22.5; also elsewhere on the board
DRIVE23+: U16.2 (6); also elsewhere on the board
DRIVE23-: U22.2 (6); also elsewhere on the board
DRIVE24+: U16.4 (7); also elsewhere on the board
DRIVE24-: U22.4 (7); also elsewhere on the board
DRIVE25+: U24.13 (0); also elsewhere on the board
DRIVE25-: U17.13 (0); also elsewhere on the board
DRIVE26+: U24.14 (1); also elsewhere on the board
DRIVE26-: U17.14 (1); also elsewhere on the board
DRIVE27+: U24.15 (2); also elsewhere on the board
DRIVE27-: U17.15 (2); also elsewhere on the board
DRIVE28+: U24.12 (3); also elsewhere on the board
DRIVE28-: U17.12 (3); also elsewhere on the board
DRIVE29+: U24.1 (4); also elsewhere on the board
DRIVE29-: U17.1 (4); also elsewhere on the board
DRIVE30+: U24.5; also elsewhere on the board
DRIVE30-: U17.5; also elsewhere on the board
DRIVE31+: U24.2 (6); also elsewhere on the board
DRIVE31-: U17.2 (6); also elsewhere on the board
DRIVE32+: U24.4 (7); also elsewhere on the board
DRIVE32-: U17.4 (7); also elsewhere on the board
DRIVE33+: U13.13 (0); also elsewhere on the board
DRIVE33-: U19.13 (0); also elsewhere on the board
DRIVE34+: U13.14 (1); also elsewhere on the board
DRIVE34-: U19.14 (1); also elsewhere on the board
DRIVE35+: U13.15 (2); also elsewhere on the board
DRIVE35-: U19.15 (2); also elsewhere on the board
DRIVE36+: U13.12 (3); also elsewhere on the board
DRIVE36-: U19.12 (3); also elsewhere on the board
DRIVE37+: U13.1 (4); also elsewhere on the board
DRIVE37-: U19.1 (4); also elsewhere on the board
DRIVE38+: U13.5; also elsewhere on the board
DRIVE38-: U19.5; also elsewhere on the board
DRIVE39+: U13.2 (6); also elsewhere on the board
DRIVE39-: U19.2 (6); also elsewhere on the board
DRIVE40+: U13.4 (7); also elsewhere on the board
DRIVE40-: U19.4 (7); also elsewhere on the board
DRIVE41+: U15.13 (0); also elsewhere on the board
DRIVE41-: U21.13 (0); also elsewhere on the board
DRIVE42+: U15.14 (1); also elsewhere on the board
DRIVE42-: U21.14 (1); also elsewhere on the board
DRIVE43+: U15.15 (2); also elsewhere on the board
DRIVE43-: U21.15 (2); also elsewhere on the board
DRIVE44+: U15.12 (3); also elsewhere on the board
DRIVE44-: U21.12 (3); also elsewhere on the board
DRIVE45+: U15.1 (4); also elsewhere on the board
DRIVE45-: U21.1 (4); also elsewhere on the board
DRIVE46+: U15.5; also elsewhere on the board
DRIVE46-: U21.5; also elsewhere on the board
DRIVE47+: U15.2 (6); also elsewhere on the board
DRIVE47-: U21.2 (6); also elsewhere on the board
DRIVE48+: U15.4 (7); also elsewhere on the board
DRIVE48-: U21.4 (7); also elsewhere on the board
DRIVE49+: U23.13 (0); also elsewhere on the board
DRIVE49-: U25.13 (0); also elsewhere on the board
DRIVE50+: U23.14 (1); also elsewhere on the board
DRIVE50-: U25.14 (1); also elsewhere on the board
IOUT+: U12.3 (COM), U13.3 (COM), U14.3 (COM), U15.3 (COM), U16.3 (COM), U23.3 (COM), U24.3 (COM); also elsewhere on the board
IOUT-: U17.3 (COM), U18.3 (COM), U19.3 (COM), U20.3 (COM), U21.3 (COM), U22.3 (COM), U25.3 (COM); also elsewhere on the board
VA+3V3: C28.1, C29.1, C30.1, C31.1, C32.1, C33.1, C34.1, C35.1, C36.1, C37.1, C38.1, C39.1, C40.1, C41.1, U12.16 (V+), U13.16 (V+), U14.16 (V+), U15.16 (V+), U16.16 (V+), U17.16 (V+), U18.16 (V+), U19.16 (V+), U20.16 (V+), U21.16 (V+), U22.16 (V+), U23.16 (V+), U24.16 (V+), U25.16 (V+); also elsewhere on the board

Notes on the sheet:
MPX

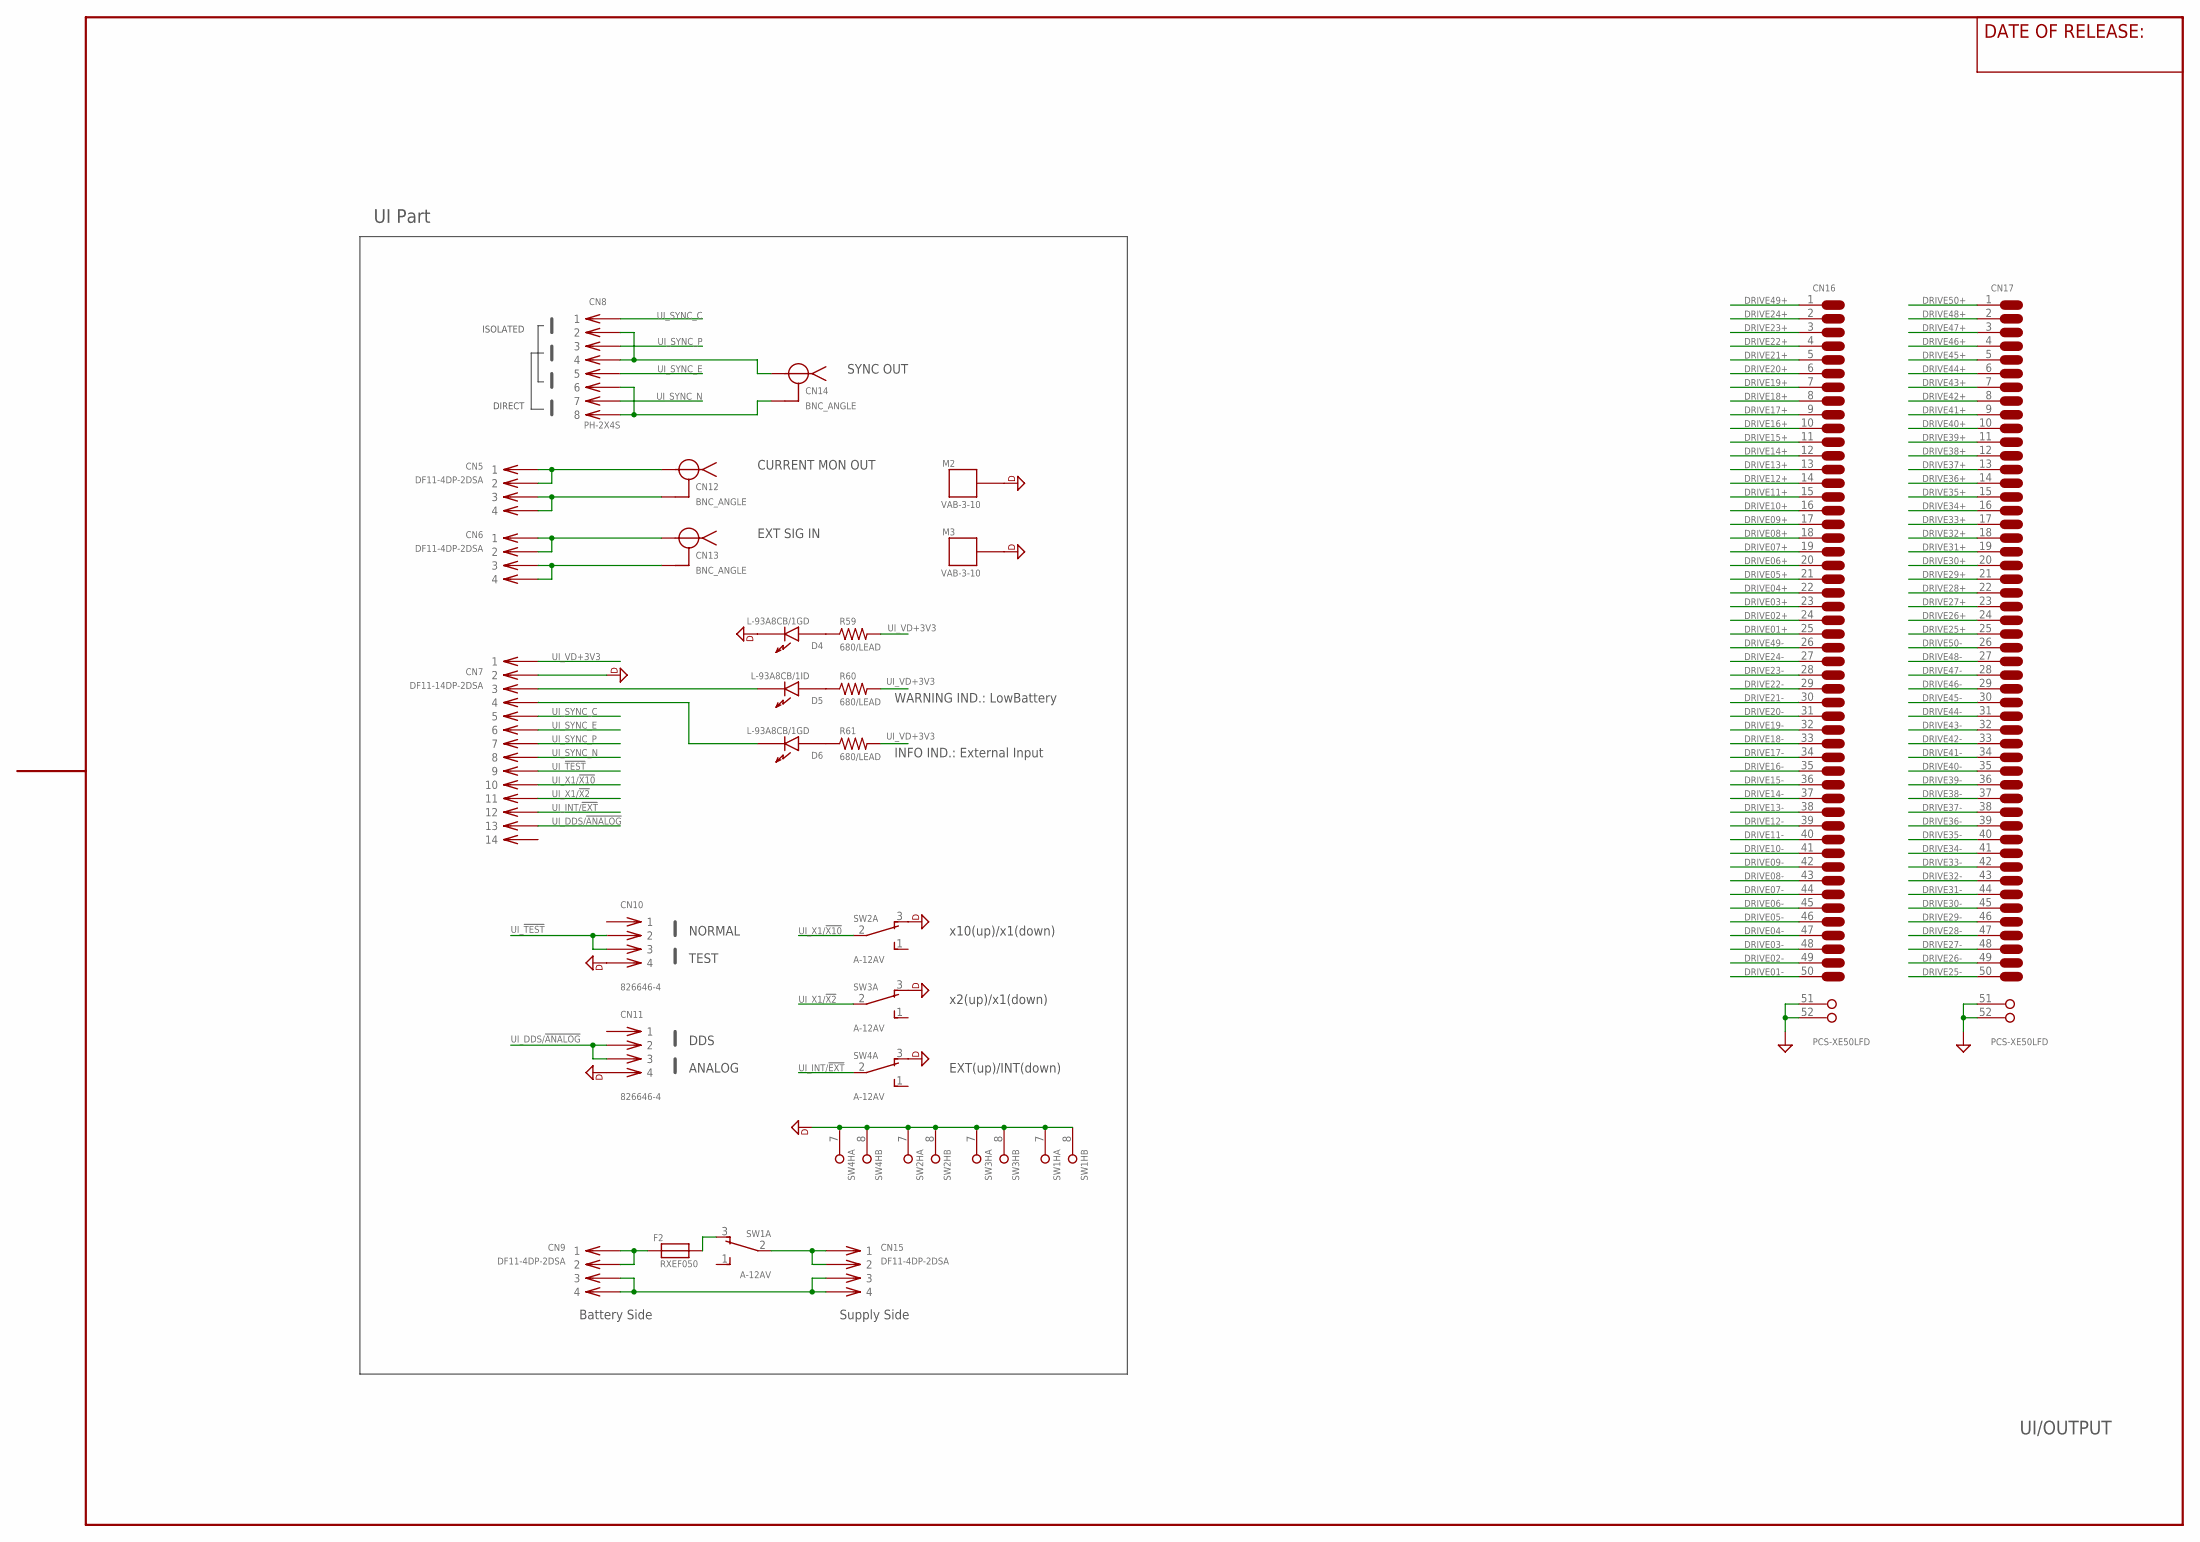
[picture p7: schematic 509_CoilDriver.sch, sheet 3]

Parts:
CN5, CN6, CN9, CN15: DF11-4DP-2DSA
CN7: DF11-14DP-2DSA
CN8: PH-2X4S; PIN_HEADER_8PIN
CN10, CN11: 826646-4; PIN_HEADER_4PIN
CN12, CN13, CN14: BNC_ANGLE; BNC_F_ANGLE
CN16, CN17: PCS-XE50LFD; 50LFD2
D4, D6: L-93A8CB/1GD; L-93A8CB
D5: L-93A8CB/1ID; L-93A8CB
F2: RXEF050; 8X3/5.08
M2, M3: VAB-3-10; VAB_3_10_CONTACT
R59, R60, R61: 680/LEAD; 0207/2V
SW1, SW2, SW3, SW4: A-12AV; A-12*

Connections:
AGND: CN16.51 (G1), CN16.52 (G2), CN17.51 (G1), CN17.52 (G2); also elsewhere on the board
DGND: CN7.2, CN10.4, CN11.4, D4.C (K1), M2.CASE1, M3.CASE1, SW1.7 (BRACKET), SW1.8 (BRACKET), SW2.3 (NC), SW2.7 (BRACKET), SW2.8 (BRACKET), SW3.3 (NC), SW3.7 (BRACKET), SW3.8 (BRACKET), SW4.3 (NC), SW4.7 (BRACKET), SW4.8 (BRACKET); also elsewhere on the board
DRIVE01+: CN16.25; also elsewhere on the board
DRIVE01-: CN16.50; also elsewhere on the board
DRIVE02+: CN16.24; also elsewhere on the board
DRIVE02-: CN16.49; also elsewhere on the board
DRIVE03+: CN16.23; also elsewhere on the board
DRIVE03-: CN16.48; also elsewhere on the board
DRIVE04+: CN16.22; also elsewhere on the board
DRIVE04-: CN16.47; also elsewhere on the board
DRIVE05+: CN16.21; also elsewhere on the board
DRIVE05-: CN16.46; also elsewhere on the board
DRIVE06+: CN16.20; also elsewhere on the board
DRIVE06-: CN16.45; also elsewhere on the board
DRIVE07+: CN16.19; also elsewhere on the board
DRIVE07-: CN16.44; also elsewhere on the board
DRIVE08+: CN16.18; also elsewhere on the board
DRIVE08-: CN16.43; also elsewhere on the board
DRIVE09+: CN16.17; also elsewhere on the board
DRIVE09-: CN16.42; also elsewhere on the board
DRIVE10+: CN16.16; also elsewhere on the board
DRIVE10-: CN16.41; also elsewhere on the board
DRIVE11+: CN16.15; also elsewhere on the board
DRIVE11-: CN16.40; also elsewhere on the board
DRIVE12+: CN16.14; also elsewhere on the board
DRIVE12-: CN16.39; also elsewhere on the board
DRIVE13+: CN16.13; also elsewhere on the board
DRIVE13-: CN16.38; also elsewhere on the board
DRIVE14+: CN16.12; also elsewhere on the board
DRIVE14-: CN16.37; also elsewhere on the board
DRIVE15+: CN16.11; also elsewhere on the board
DRIVE15-: CN16.36; also elsewhere on the board
DRIVE16+: CN16.10; also elsewhere on the board
DRIVE16-: CN16.35; also elsewhere on the board
DRIVE17+: CN16.9; also elsewhere on the board
DRIVE17-: CN16.34; also elsewhere on the board
DRIVE18+: CN16.8; also elsewhere on the board
DRIVE18-: CN16.33; also elsewhere on the board
DRIVE19+: CN16.7; also elsewhere on the board
DRIVE19-: CN16.32; also elsewhere on the board
DRIVE20+: CN16.6; also elsewhere on the board
DRIVE20-: CN16.31; also elsewhere on the board
DRIVE21+: CN16.5; also elsewhere on the board
DRIVE21-: CN16.30; also elsewhere on the board
DRIVE22+: CN16.4; also elsewhere on the board
DRIVE22-: CN16.29; also elsewhere on the board
DRIVE23+: CN16.3; also elsewhere on the board
DRIVE23-: CN16.28; also elsewhere on the board
DRIVE24+: CN16.2; also elsewhere on the board
DRIVE24-: CN16.27; also elsewhere on the board
DRIVE25+: CN17.25; also elsewhere on the board
DRIVE25-: CN17.50; also elsewhere on the board
DRIVE26+: CN17.24; also elsewhere on the board
DRIVE26-: CN17.49; also elsewhere on the board
DRIVE27+: CN17.23; also elsewhere on the board
DRIVE27-: CN17.48; also elsewhere on the board
DRIVE28+: CN17.22; also elsewhere on the board
DRIVE28-: CN17.47; also elsewhere on the board
DRIVE29+: CN17.21; also elsewhere on the board
DRIVE29-: CN17.46; also elsewhere on the board
DRIVE30+: CN17.20; also elsewhere on the board
DRIVE30-: CN17.45; also elsewhere on the board
DRIVE31+: CN17.19; also elsewhere on the board
DRIVE31-: CN17.44; also elsewhere on the board
DRIVE32+: CN17.18; also elsewhere on the board
DRIVE32-: CN17.43; also elsewhere on the board
DRIVE33+: CN17.17; also elsewhere on the board
DRIVE33-: CN17.42; also elsewhere on the board
DRIVE34+: CN17.16; also elsewhere on the board
DRIVE34-: CN17.41; also elsewhere on the board
DRIVE35+: CN17.15; also elsewhere on the board
DRIVE35-: CN17.40; also elsewhere on the board
DRIVE36+: CN17.14; also elsewhere on the board
DRIVE36-: CN17.39; also elsewhere on the board
DRIVE37+: CN17.13; also elsewhere on the board
DRIVE37-: CN17.38; also elsewhere on the board
DRIVE38+: CN17.12; also elsewhere on the board
DRIVE38-: CN17.37; also elsewhere on the board
DRIVE39+: CN17.11; also elsewhere on the board
DRIVE39-: CN17.36; also elsewhere on the board
DRIVE40+: CN17.10; also elsewhere on the board
DRIVE40-: CN17.35; also elsewhere on the board
DRIVE41+: CN17.9; also elsewhere on the board
DRIVE41-: CN17.34; also elsewhere on the board
DRIVE42+: CN17.8; also elsewhere on the board
DRIVE42-: CN17.33; also elsewhere on the board
DRIVE43+: CN17.7; also elsewhere on the board
DRIVE43-: CN17.32; also elsewhere on the board
DRIVE44+: CN17.6; also elsewhere on the board
DRIVE44-: CN17.31; also elsewhere on the board
DRIVE45+: CN17.5; also elsewhere on the board
DRIVE45-: CN17.30; also elsewhere on the board
DRIVE46+: CN17.4; also elsewhere on the board
DRIVE46-: CN17.29; also elsewhere on the board
DRIVE47+: CN17.3; also elsewhere on the board
DRIVE47-: CN17.28; also elsewhere on the board
DRIVE48+: CN17.2; also elsewhere on the board
DRIVE48-: CN17.27; also elsewhere on the board
DRIVE49+: CN16.1; also elsewhere on the board
DRIVE49-: CN16.26; also elsewhere on the board
DRIVE50+: CN17.1; also elsewhere on the board
DRIVE50-: CN17.26; also elsewhere on the board
unnamed: CN7.3, D5.C (K1)
unnamed: D5.A (A1), R60.1
unnamed: D6.A (A1), R61.1
unnamed: CN7.4, D6.C (K1)
unnamed: CN8.2, CN8.4, CN14.P$1
unnamed: CN8.6, CN8.8, CN14.P$2
unnamed: CN6.1, CN6.2, CN13.P$1
unnamed: CN6.3, CN6.4, CN13.P$2
unnamed: CN5.3, CN5.4, CN12.P$2
unnamed: CN5.1, CN5.2, CN12.P$1
unnamed: CN9.1, CN9.2, F2.1
unnamed: F2.2, SW1.3 (NC)
unnamed: CN9.3, CN9.4, CN15.3, CN15.4
unnamed: D4.A (A1), R59.1
unnamed: CN15.1, CN15.2, SW1.2 (C)
UI_!TEST!: CN7.9, CN10.2, CN10.3
UI_DDS/!ANALOG!: CN7.13, CN11.2, CN11.3
UI_INT/!EXT!: CN7.12, SW4.2 (C)
UI_SYNC_C: CN7.5, CN8.1
UI_SYNC_E: CN7.6, CN8.5
UI_SYNC_N: CN7.8, CN8.7
UI_SYNC_P: CN7.7, CN8.3
UI_VD+3V3: CN7.1, R59.2, R60.2, R61.2
UI_X1/!X2!: CN7.11, SW3.2 (C)
UI_X1/!X10!: CN7.10, SW2.2 (C)

Notes on the sheet:
UI/OUTPUT
WARNING IND.: LowBattery
INFO IND.: External Input
EXT(up)/INT(down)
x2(up)/x1(down)
x10(up)/x1(down)
NORMAL
TEST
DDS
ANALOG
SYNC OUT
ISOLATED
DIRECT
CURRENT MON OUT
EXT SIG IN
Battery Side
Supply Side
UI Part
