mm011106/509_circuit/509_CoilDriver.brd

## EAGLE design 509_CoilDriver.brd (continued)

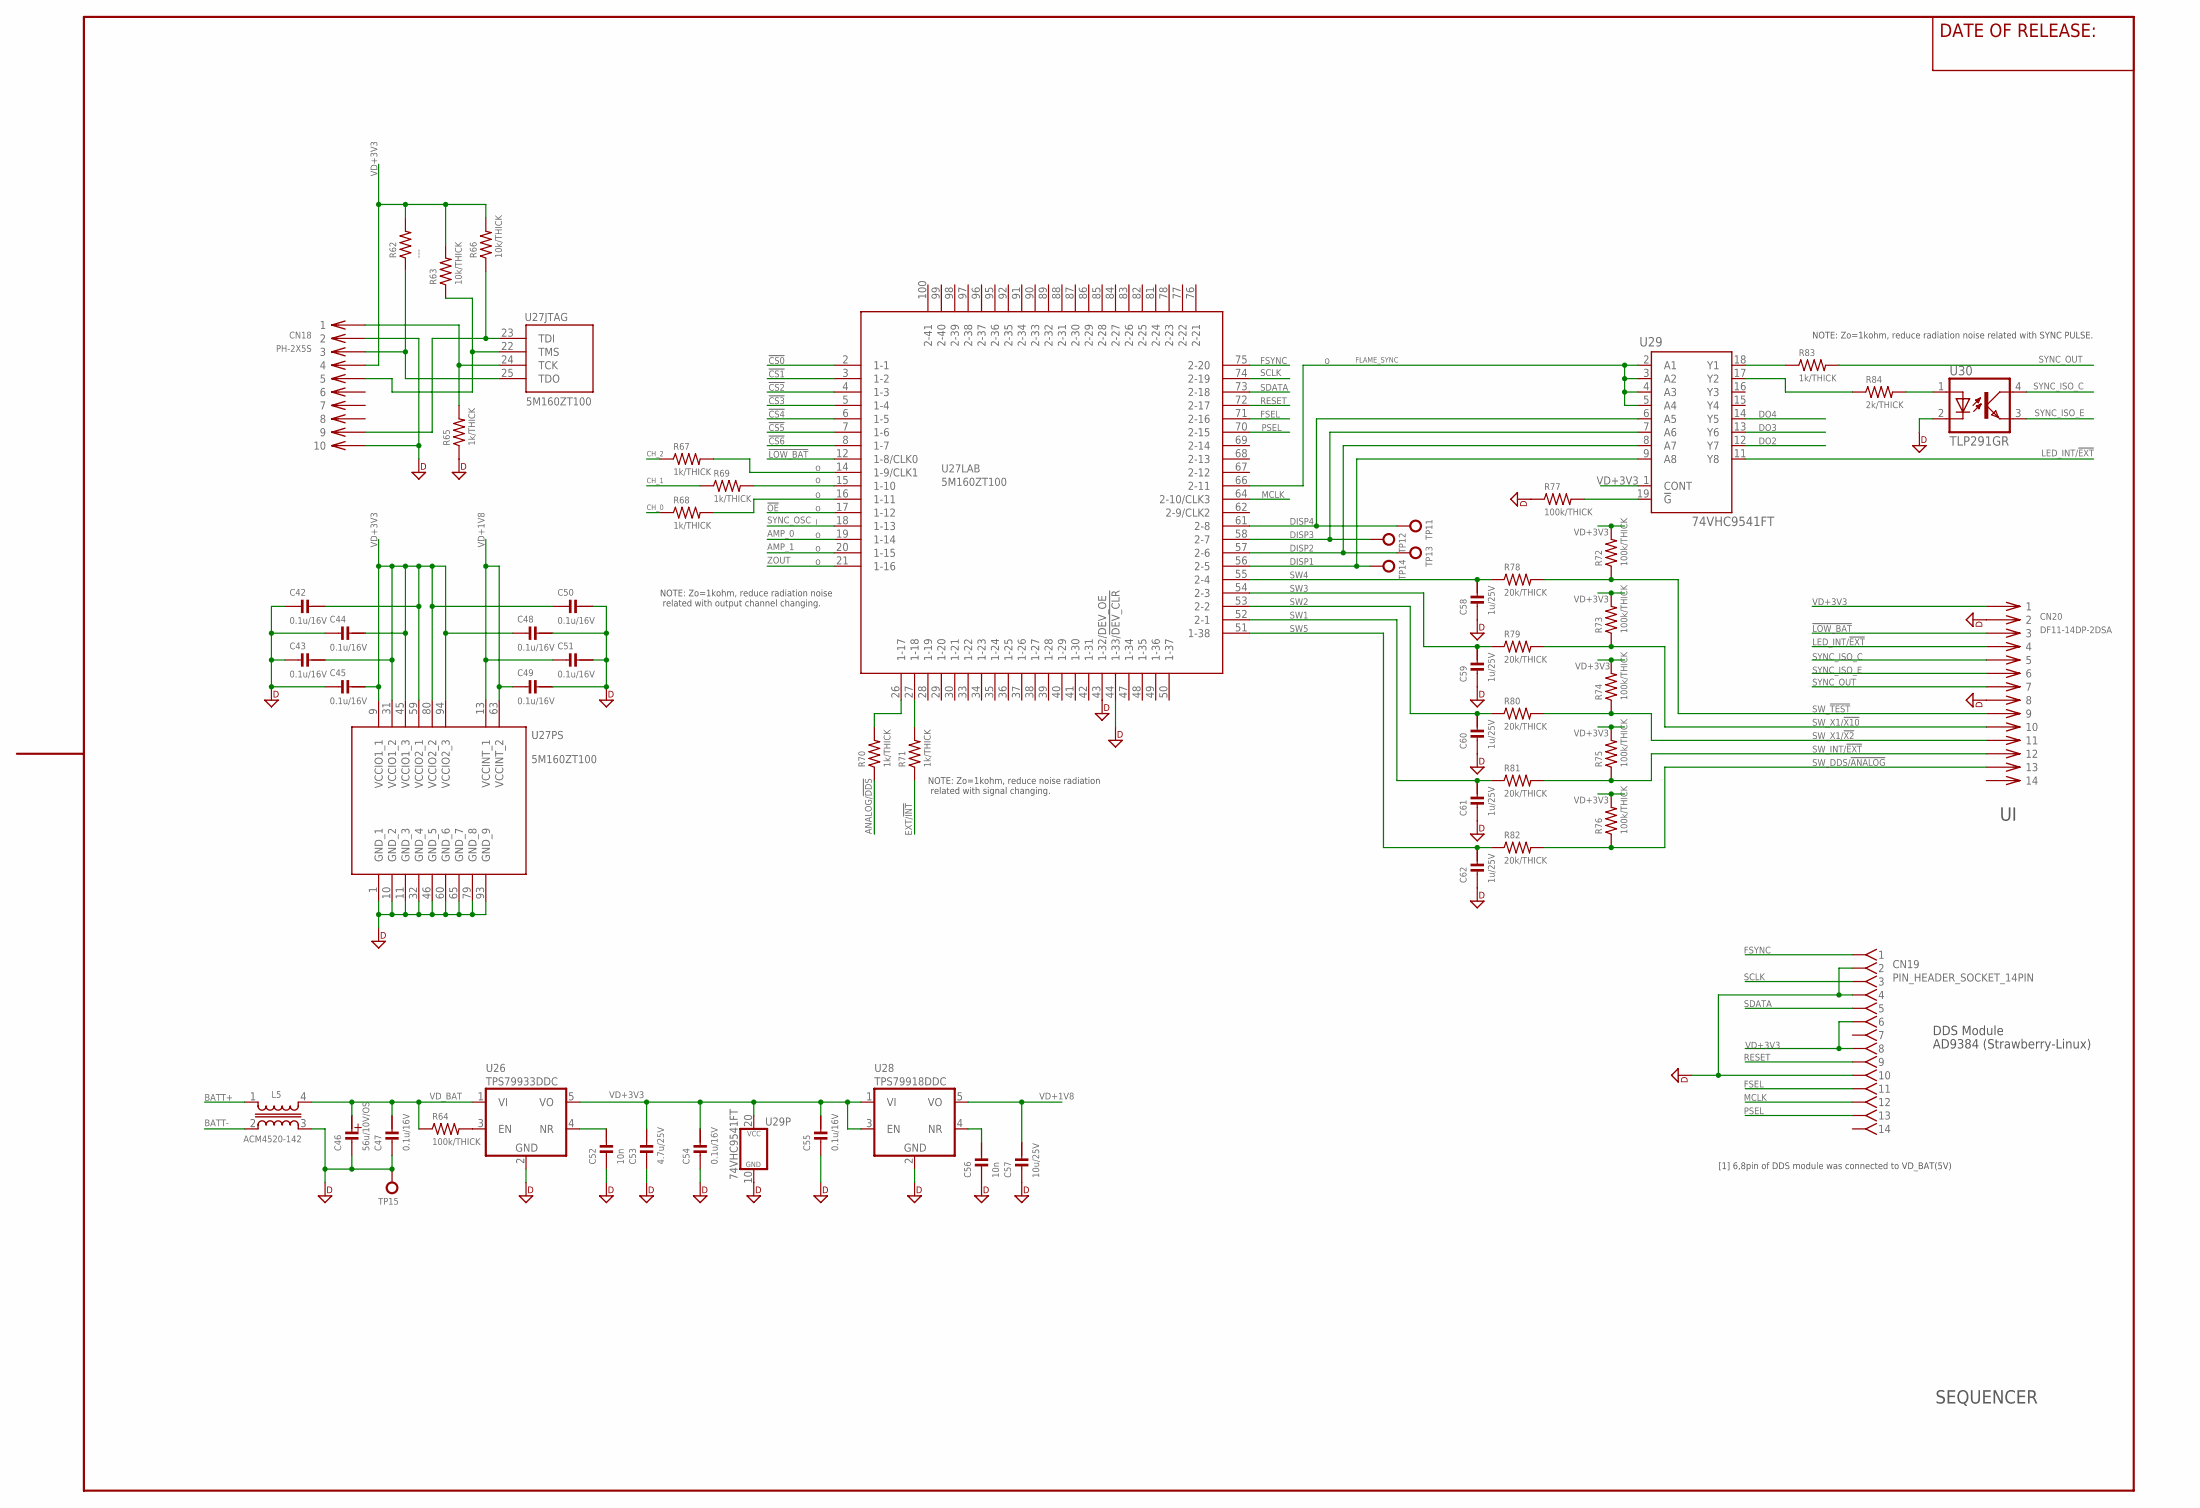
[picture p8: schematic 509_CoilDriver.sch, sheet 4]

Parts:
C42, C43, C44, C45, C47, C48, C49, C50, C51, C54, C55: 0.1u/16V; CM1005
C46: 56u/10V/OS; PHI_6.3
C52, C56: 10n; CM2012
C53: 4.7u/25V; CM2012
C57: 10u/25V; CM3216
C58, C59, C60, C61, C62: 1u/25V; CM1608
CN18: PH-2X5S; PIN_HEADER_10PIN
CN19: PIN_HEADER_SOCKET_14PIN
CN20: DF11-14DP-2DSA
L5: ACM4520-142; ACM4520
R62: ---; RM1608
R63, R66: 10k/THICK; RM1608
R64, R72, R73, R74, R75, R76, R77: 100k/THICK; RM1608
R65, R67, R68, R69, R70, R71, R83: 1k/THICK; RM1608
R78, R79, R80, R81, R82: 20k/THICK; RM1608
R84: 2k/THICK; RM1608
TP11, TP12, TP13, TP14: TP-1MMPAD; TP_PAD_1MM
TP15: TP-LC3G; TP_TH_0R9MM
U26: TPS79933DDC; SOT-23-5
U27: 5M160ZT100; QFP100_0.5
U28: TPS79918DDC; SOT-23-5
U29: 74VHC9541FT; TSSOP20-P-0044-065A
U30: TLP291GR; SO4(11-3C1)(TOSHIBA)

Connections:
!CS0: U27.2 (1-1); also elsewhere on the board
!CS1: U27.3 (1-2); also elsewhere on the board
!CS2: U27.4 (1-3); also elsewhere on the board
!CS3: U27.5 (1-4); also elsewhere on the board
!CS4: U27.6 (1-5); also elsewhere on the board
!CS5: U27.7 (1-6); also elsewhere on the board
!CS6: U27.8 (1-7); also elsewhere on the board
!LOW_BAT: CN20.3, U27.12 (1-8/CLK0); also elsewhere on the board
!OE: U27.17 (1-12)
AMP_0: U27.19 (1-14); also elsewhere on the board
AMP_1: U27.20 (1-15); also elsewhere on the board
ANALOG/!DDS!: R70.1; also elsewhere on the board
BATT+: L5.1; also elsewhere on the board
BATT-: L5.2 (3); also elsewhere on the board
CH_0: R68.1; also elsewhere on the board
CH_1: R69.1; also elsewhere on the board
CH_2: R67.1; also elsewhere on the board
DGND: C42.2, C43.2, C44.2, C45.2, C46.NEG, C47.2, C48.1, C49.1, C50.1, C51.1, C52.2, C53.2, C54.2, C55.2, C56.2, C57.2, C58.2, C59.2, C60.2, C61.2, C62.2, CN18.2, CN18.10, CN19.2, CN19.4, CN19.10, CN20.2, CN20.8, L5.3 (4), R65.1, R77.1, TP15.1, U26.2 (GND), U27.1 (GND_1), U27.10 (GND_2), U27.11 (GND_3), U27.32 (GND_4), U27.43 (1-32/DEV_OE), U27.44 (1-33/!DEV_CLR), U27.46 (GND_5), U27.60 (GND_6), U27.65 (GND_7), U27.79 (GND_8), U27.93 (GND_9), U28.2 (GND), U29.10 (GND), U30.2 (C); also elsewhere on the board
DISP1: TP14.P$1, U27.56 (2-5), U29.9 (A8)
DISP2: TP13.P$1, U27.57 (2-6), U29.8 (A7)
DISP3: TP12.P$1, U27.58 (2-7), U29.7 (A6)
DISP4: TP11.P$1, U27.61 (2-8), U29.6 (A5)
DO2: U29.12 (Y7)
DO3: U29.13 (Y6)
DO4: U29.14 (Y5)
EXT/!INT!: R71.1; also elsewhere on the board
FLAME_SYNC: U27.66 (2-11), U29.2 (A1), U29.3 (A2), U29.4 (A3), U29.5 (A4)
FSEL: CN19.11, U27.71 (2-16)
FSYNC: CN19.1, U27.75 (2-20)
LED_INT/!EXT!: CN20.4, U29.11 (Y8)
MCLK: CN19.12, U27.64 (2-10/CLK3)
unnamed: R69.2, U27.15 (1-10)
unnamed: R68.2, U27.16 (1-11)
unnamed: R83.1, U29.18 (Y1)
unnamed: R77.2, U29.19 (!G)
unnamed: C52.1, U26.4 (NR)
unnamed: R64.2, U26.3 (EN)
unnamed: R70.2, U27.26 (1-17)
unnamed: CN18.9, R66.1, U27.23 (TDI)
unnamed: CN18.1, R65.2, U27.24 (TCK)
unnamed: R67.2, U27.14 (1-9/CLK1)
unnamed: R71.2, U27.27 (1-18)
unnamed: CN18.3, R62.1, U27.25 (TDO)
unnamed: CN18.5, R63.1, U27.22 (TMS)
unnamed: R84.1, U29.17 (Y2)
unnamed: C56.1, U28.4 (NR)
unnamed: R84.2, U30.1 (A)
PSEL: CN19.13, U27.70 (2-15)
RESET: CN19.9, U27.72 (2-17)
SCLK: CN19.3, U27.74 (2-19)
SDATA: CN19.5, U27.73 (2-18)
SW1: C61.1, R81.1, U27.52 (2-1)
SW2: C60.1, R80.1, U27.53 (2-2)
SW3: C59.1, R79.1, U27.54 (2-3)
SW4: C58.1, R78.1, U27.55 (2-4)
SW5: C62.1, R82.1, U27.51 (1-38)
SW_!TEST!: CN20.9, R72.1, R78.2
SW_DDS/!ANALOG!: CN20.13, R76.1, R82.2
SW_INT/!EXT: CN20.12, R75.1, R81.2
SW_X1/!X2!: CN20.11, R74.1, R80.2
SW_X1/!X10!: CN20.10, R73.1, R79.2
SYNC_ISO_C: CN20.5, U30.4 (COL)
SYNC_ISO_E: CN20.6, U30.3 (EMI)
SYNC_OSC: U27.18 (1-13); also elsewhere on the board
SYNC_OUT: CN20.7, R83.2
VD+1V8: C49.2, C51.2, C57.1, U27.13 (VCCINT_1), U27.63 (VCCINT_2), U28.5 (VO)
VD+3V3: C42.1, C43.1, C44.1, C45.1, C48.2, C50.2, C53.1, C54.1, C55.1, CN18.4, CN19.6, CN19.8, CN20.1, R62.2, R63.2, R66.2, R72.2, R73.2, R74.2, R75.2, R76.2, U26.5 (VO), U27.9 (VCCIO1_1), U27.31 (VCCIO1_2), U27.45 (VCCIO1_3), U27.59 (VCCIO2_1), U27.80 (VCCIO2_2), U27.94 (VCCIO2_3), U28.1 (VI), U28.3 (EN), U29.1 (CONT), U29.20 (VCC); also elsewhere on the board
VD_BAT: C46.POS, C47.1, L5.4 (2), R64.1, U26.1 (VI); also elsewhere on the board
ZOUT: U27.21 (1-16); also elsewhere on the board

Notes on the sheet:
SEQUENCER
DDS Module
AD9384 (Strawberry-Linux)
[1] 6,8pin of DDS module was connected to VD_BAT(5V)
NOTE: Zo=1kohm, reduce radiation noise related with SYNC PULSE.
NOTE: Zo=1kohm, reduce radiation noise related with output channel changing.
NOTE: Zo=1kohm, reduce noise radiation related with signal changing.

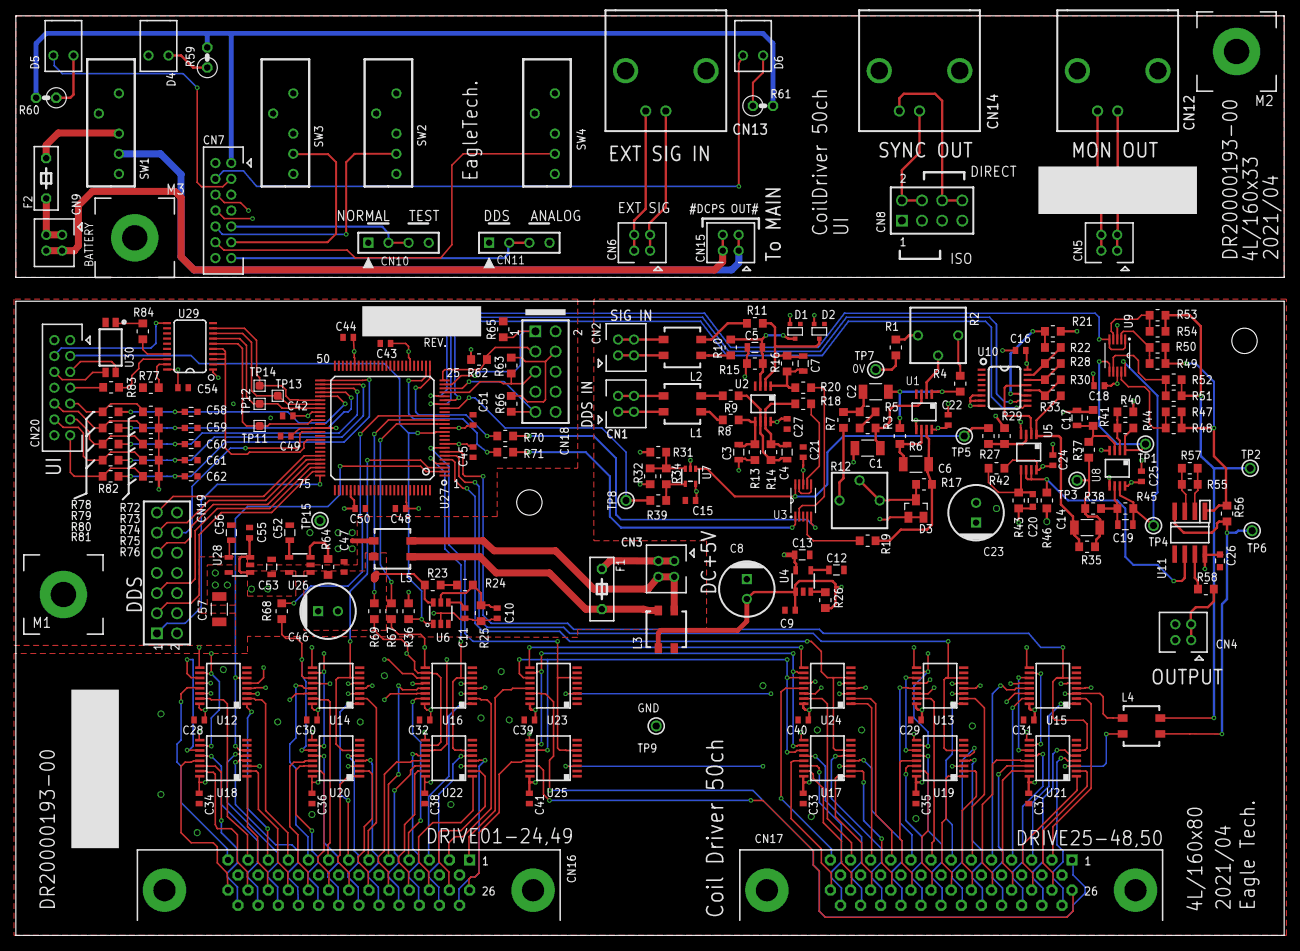
[picture p9: board 509_CoilDriver.brd from above]

Board: 4 copper layers, 160.0 x 116.0 mm, 231 parts (0 on the bottom side), 260 nets.

Other parts of the board:
U$2: 3MM_STAT
