mm011106/509_circuit/(commit log)

2021-03-12 不具合修正完了
    [PhantomDriver_ER150D.brd, PhantomDriver_ER150D.sch]
2021-03-12 change file name
    [509_CoilDriver.brd, 509_CoilDriver.sch]
2021-03-15 modify Zout and Output Op-amps
    [509_CoilDriver.brd, 509_CoilDriver.sch]
2021-03-15 obsolate files from the last vaersion
    [ER150D_24ch_parts_main_PBAN.xlsx, ER150D_50ch_parts_UI_PBAN.xlsx]
